eSpark-Backup/eamonelkhedrawi-boarddesign/Design Files/Power-PCB/Deliverables/Renderings/3D-IsometricView.png

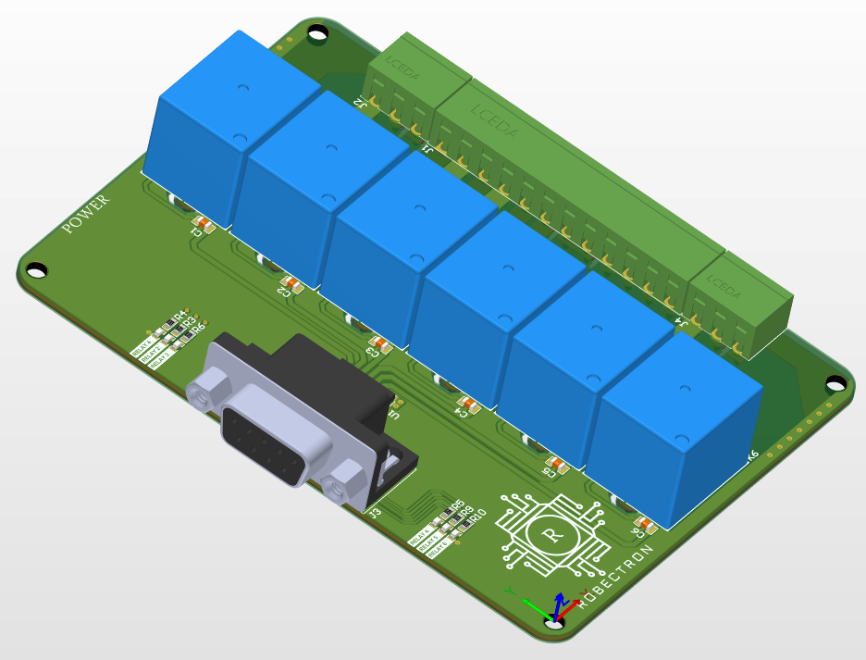
Design Files/Power-PCB/Deliverables/Renderings/3D-IsometricView.png
