eSpark-Backup/eamonelkhedrawi-boarddesign/Design Files/Chemist-PCB/Deliverables/Renderings/2D-BottomView.png

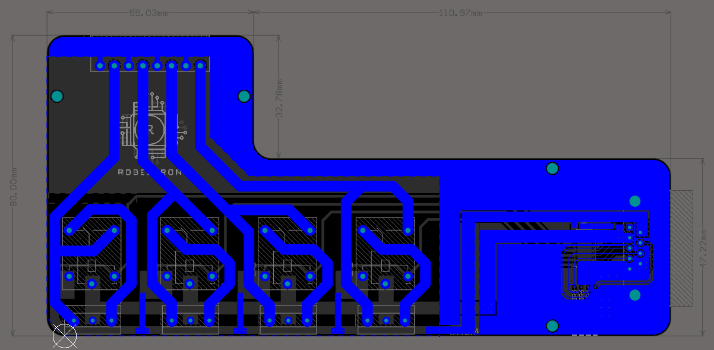
Design Files/Chemist-PCB/Deliverables/Renderings/2D-BottomView.png
