eSpark-Backup/eamonelkhedrawi-boarddesign/Design Files/Chemist-PCB/Deliverables/Renderings/2D-C-View.png

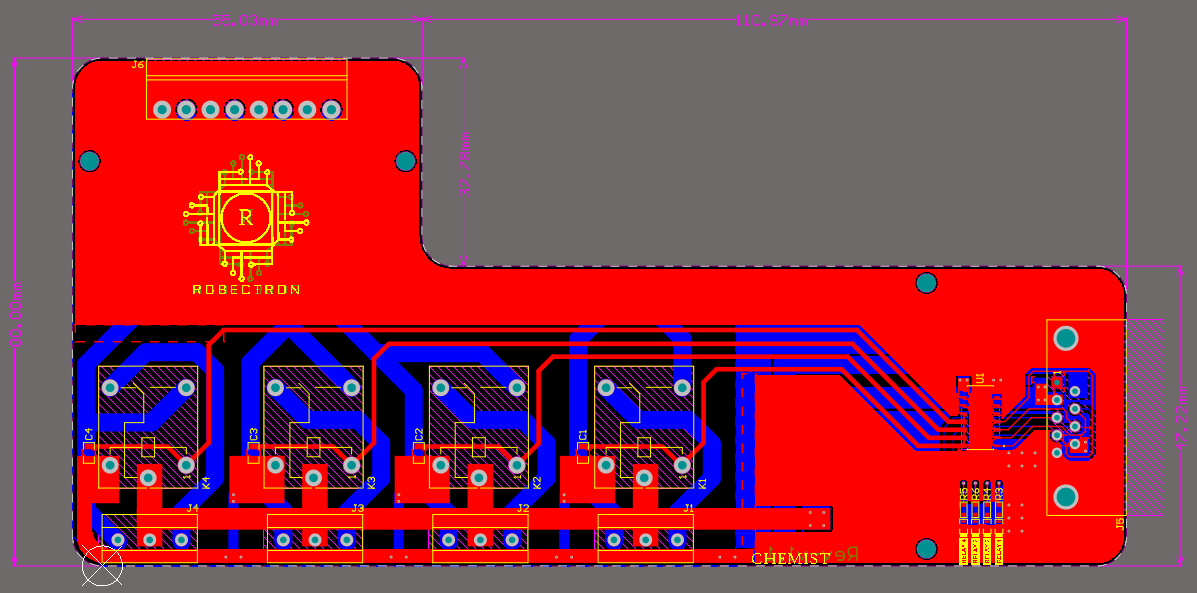
Design Files/Chemist-PCB/Deliverables/Renderings/2D-C-View.png
