eSpark-Backup/eamonelkhedrawi-boarddesign/Design Files/Chemist-PCB/Deliverables/Renderings/2D-TopView.png

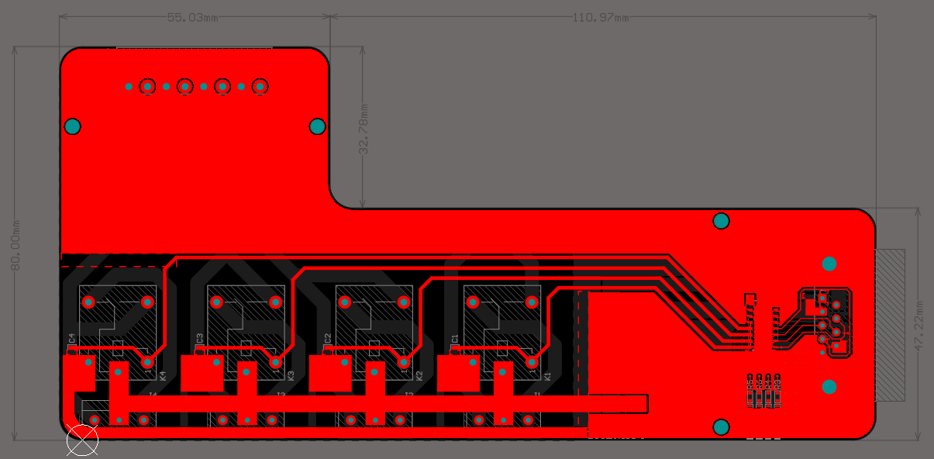
Design Files/Chemist-PCB/Deliverables/Renderings/2D-TopView.png
