eSpark-Backup/eamonelkhedrawi-boarddesign/Design Files/Chemist-PCB/Deliverables/Renderings/3D-BottomView.png

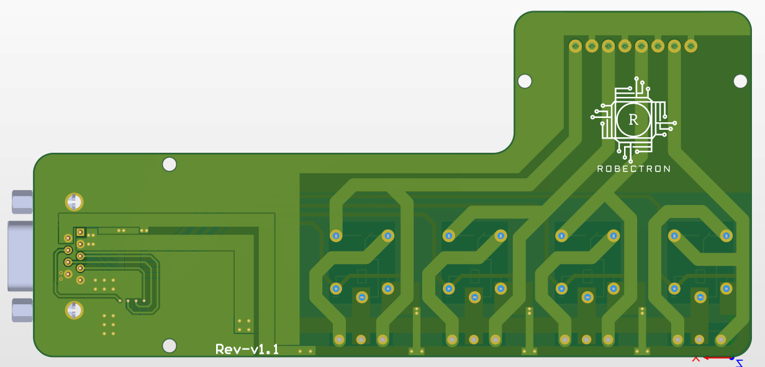
Design Files/Chemist-PCB/Deliverables/Renderings/3D-BottomView.png
