eSpark-Backup/eamonelkhedrawi-boarddesign/Design Files/Chemist-PCB/Deliverables/Renderings/3D-IsometricView.png

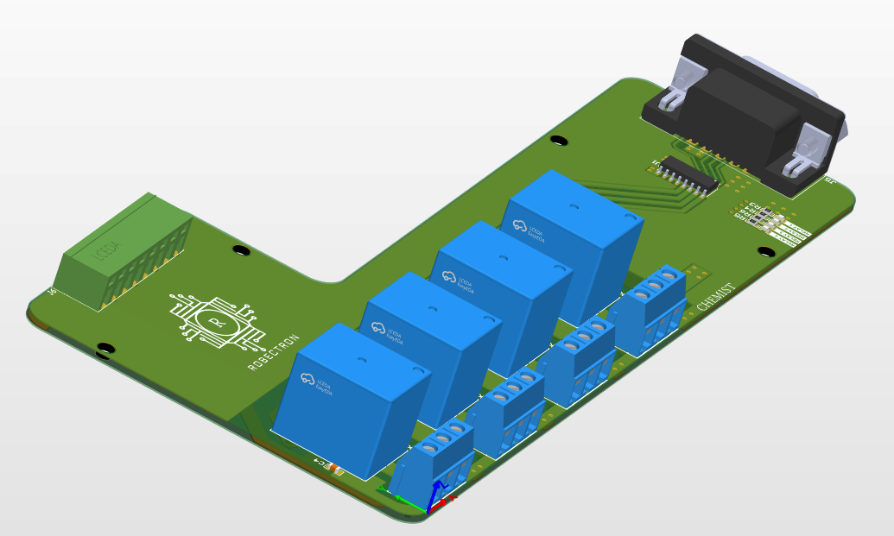
Design Files/Chemist-PCB/Deliverables/Renderings/3D-IsometricView.png
