eSpark-Backup/eamonelkhedrawi-boarddesign/Design Files/Chemist-PCB/Deliverables/Renderings/3D-TopView.png

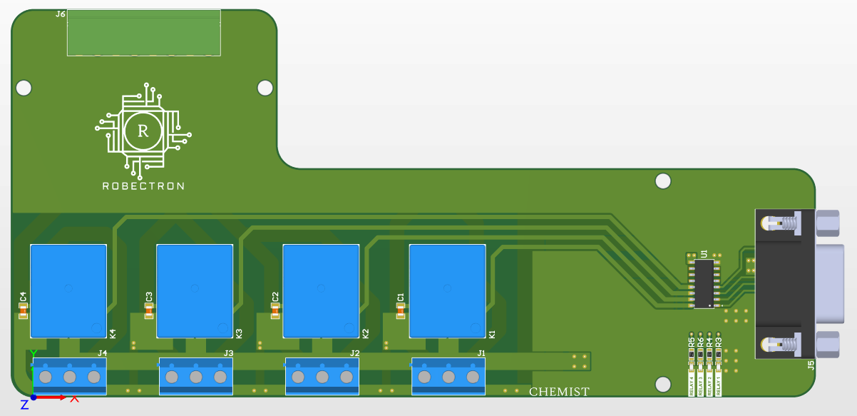
Design Files/Chemist-PCB/Deliverables/Renderings/3D-TopView.png
