eSpark-Backup/eamonelkhedrawi-boarddesign/Design Files/Main-PCB/Deliverables/Renderings/2D-2ndLayerView.png

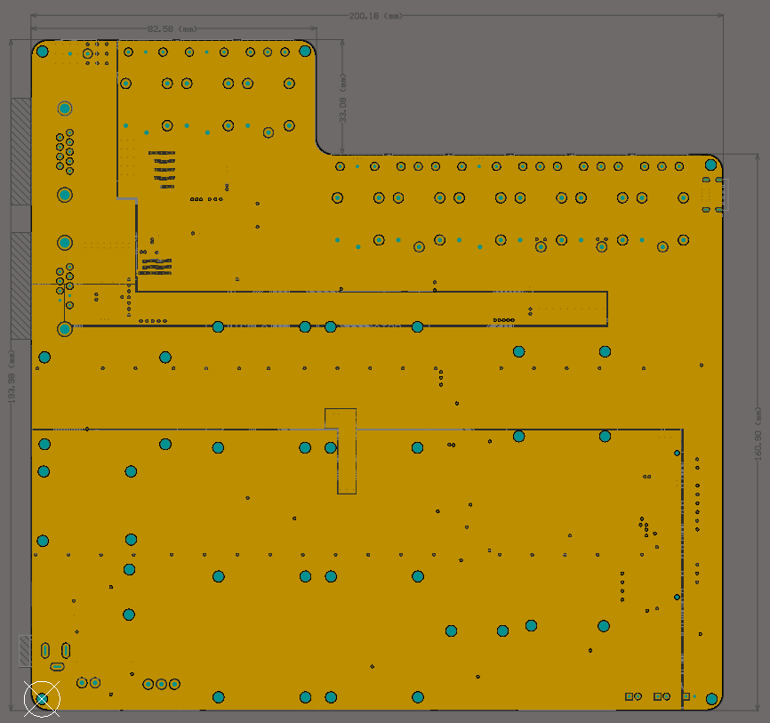
Design Files/Main-PCB/Deliverables/Renderings/2D-2ndLayerView.png
