eSpark-Backup/eamonelkhedrawi-boarddesign/Design Files/Main-PCB/Deliverables/Renderings/2D-3rdLayerView.png

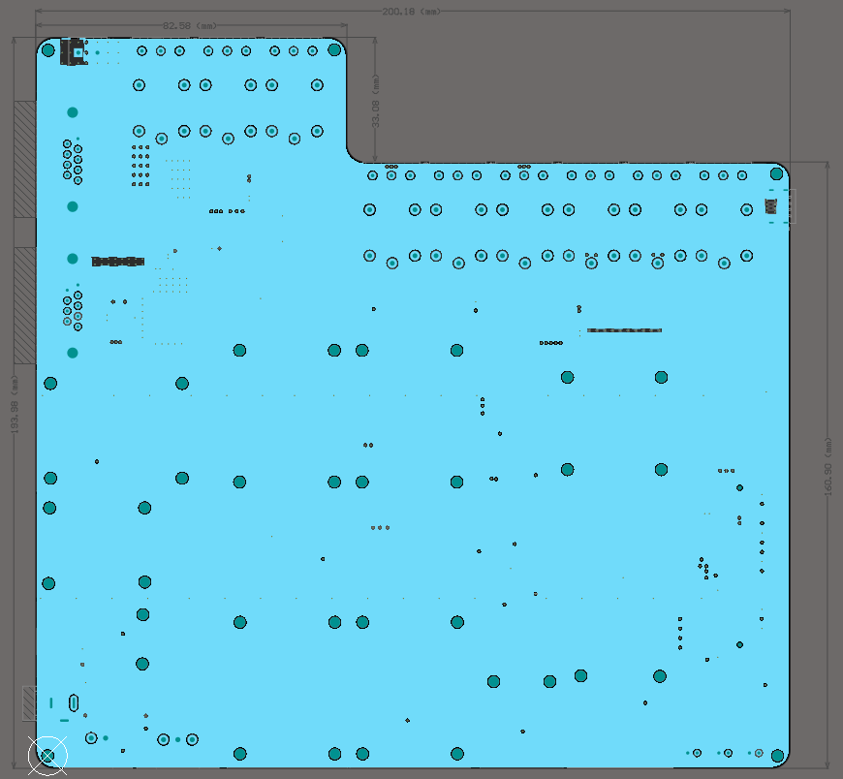
Design Files/Main-PCB/Deliverables/Renderings/2D-3rdLayerView.png
