eSpark-Backup/eamonelkhedrawi-boarddesign/Design Files/Main-PCB/Deliverables/Renderings/2D-BottomView.png

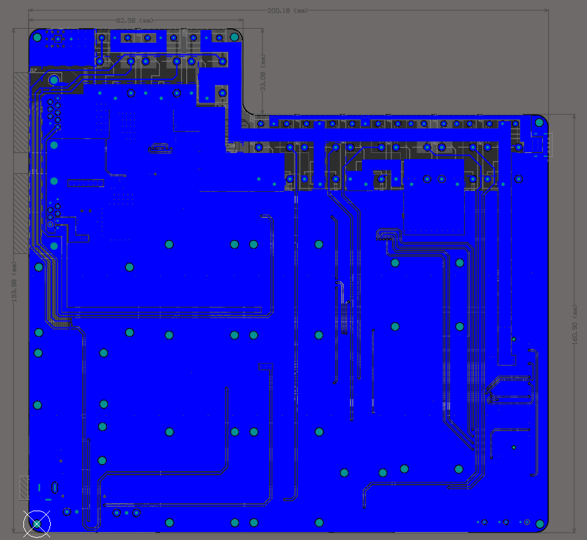
Design Files/Main-PCB/Deliverables/Renderings/2D-BottomView.png
