eSpark-Backup/eamonelkhedrawi-boarddesign/Design Files/Main-PCB/Deliverables/Renderings/2D-C-View.png

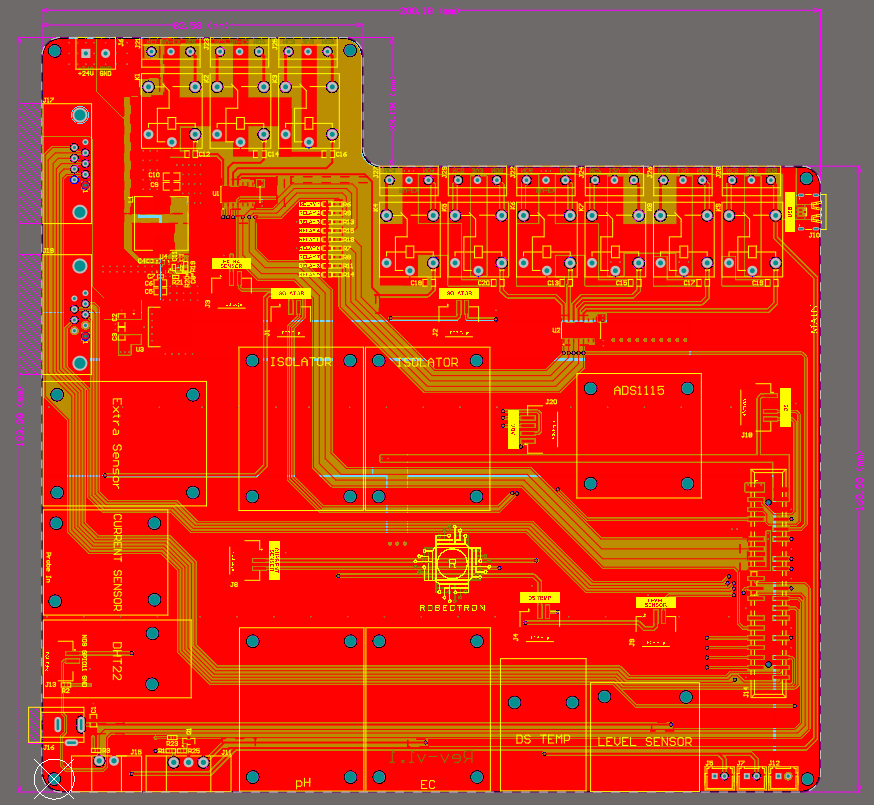
Design Files/Main-PCB/Deliverables/Renderings/2D-C-View.png
