eSpark-Backup/eamonelkhedrawi-boarddesign/Design Files/Main-PCB/Deliverables/Renderings/2D-TopView.png

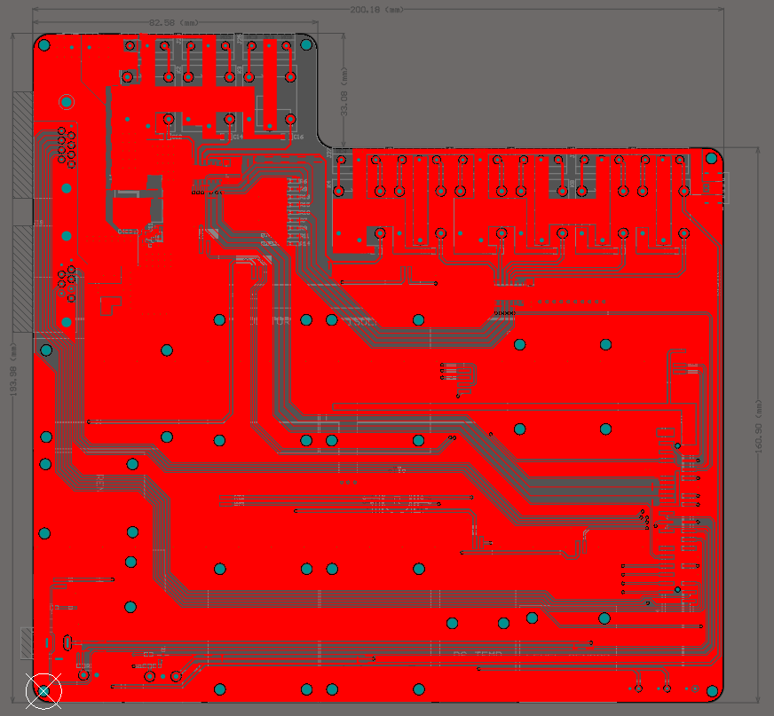
Design Files/Main-PCB/Deliverables/Renderings/2D-TopView.png
