eSpark-Backup/eamonelkhedrawi-boarddesign/Design Files/Main-PCB/Deliverables/Renderings/3D-BottomView.png

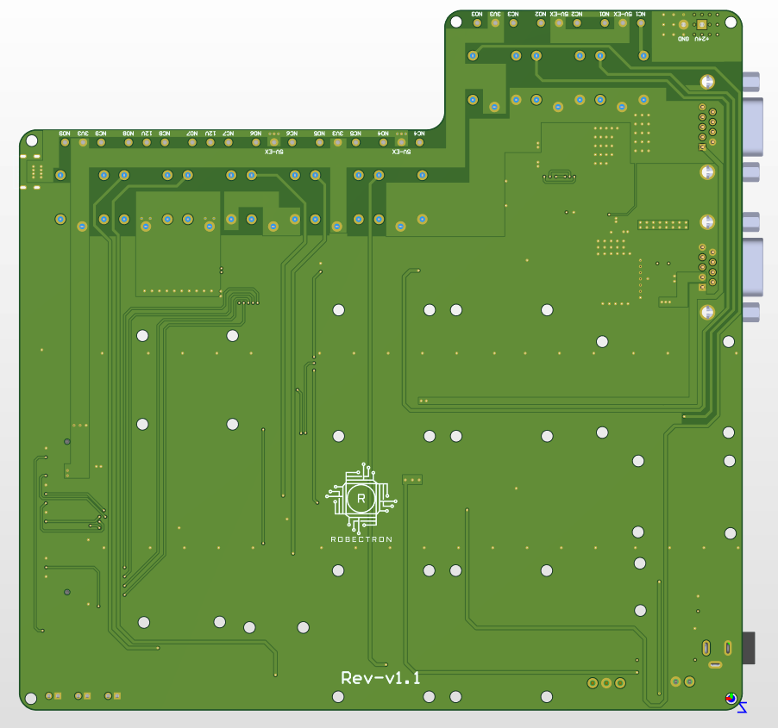
Design Files/Main-PCB/Deliverables/Renderings/3D-BottomView.png
