eSpark-Backup/eamonelkhedrawi-boarddesign/Design Files/Main-PCB/Deliverables/Renderings/3D-IsometricView.png

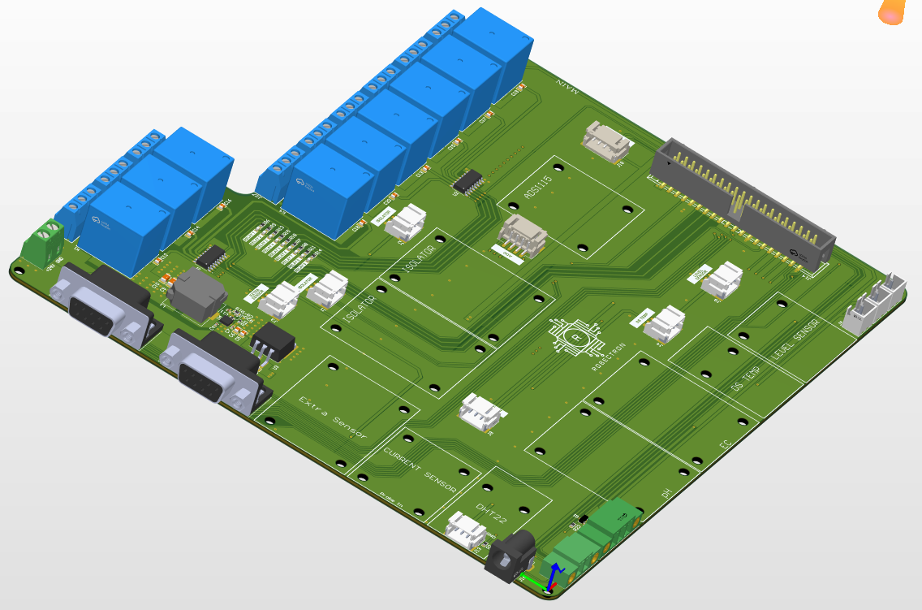
Design Files/Main-PCB/Deliverables/Renderings/3D-IsometricView.png
