eSpark-Backup/eamonelkhedrawi-boarddesign/Design Files/Main-PCB/Deliverables/Renderings/3D-TopView.png

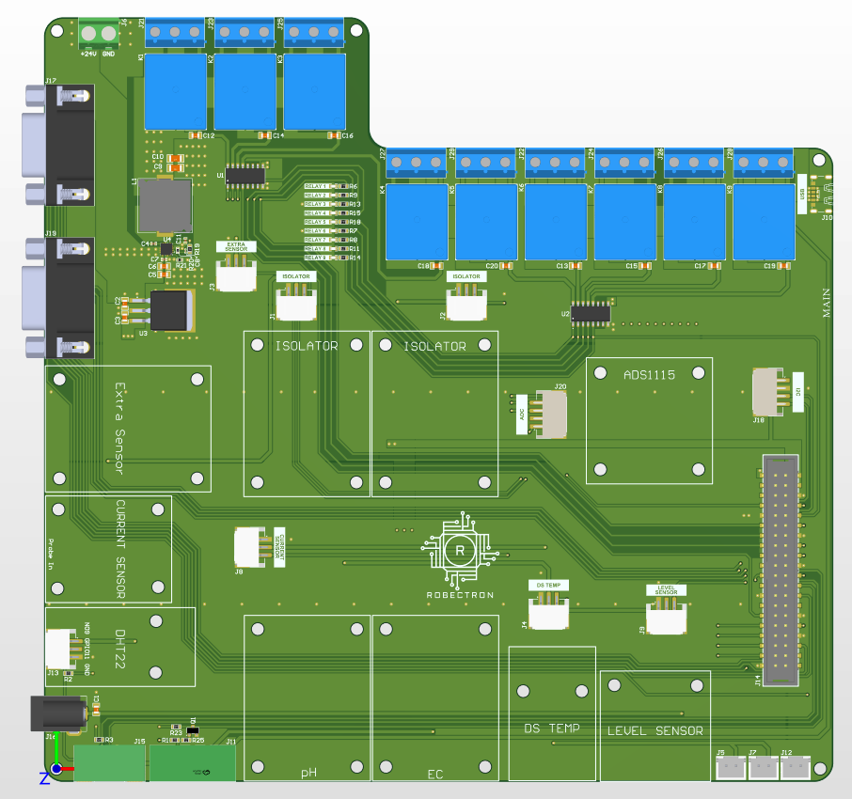
Design Files/Main-PCB/Deliverables/Renderings/3D-TopView.png
