eSpark-Backup/eamonelkhedrawi-boarddesign/Design Files/Power-PCB/Deliverables/Renderings/2D-BottomView.png

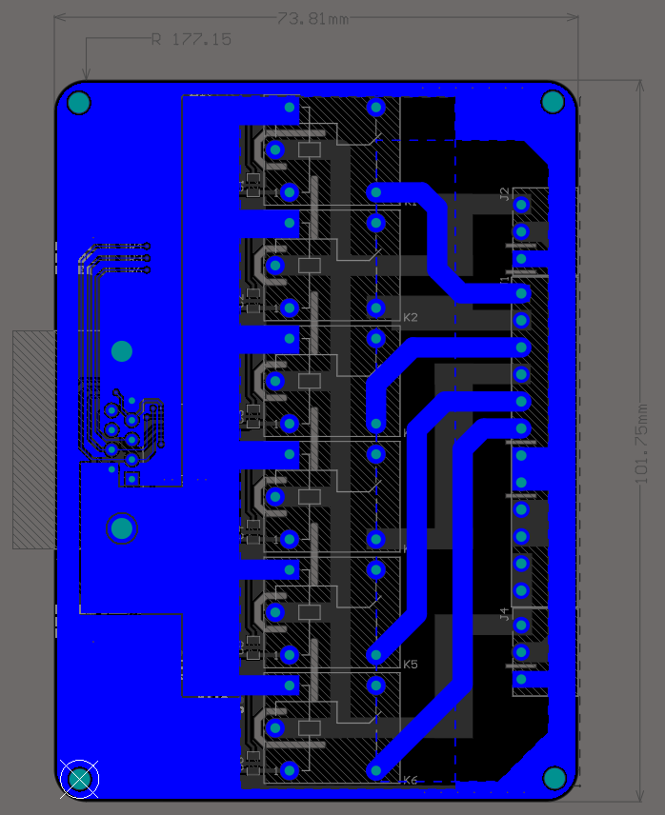
Design Files/Power-PCB/Deliverables/Renderings/2D-BottomView.png
