eSpark-Backup/eamonelkhedrawi-boarddesign/Design Files/Power-PCB/Deliverables/Renderings/2D-C-View.png

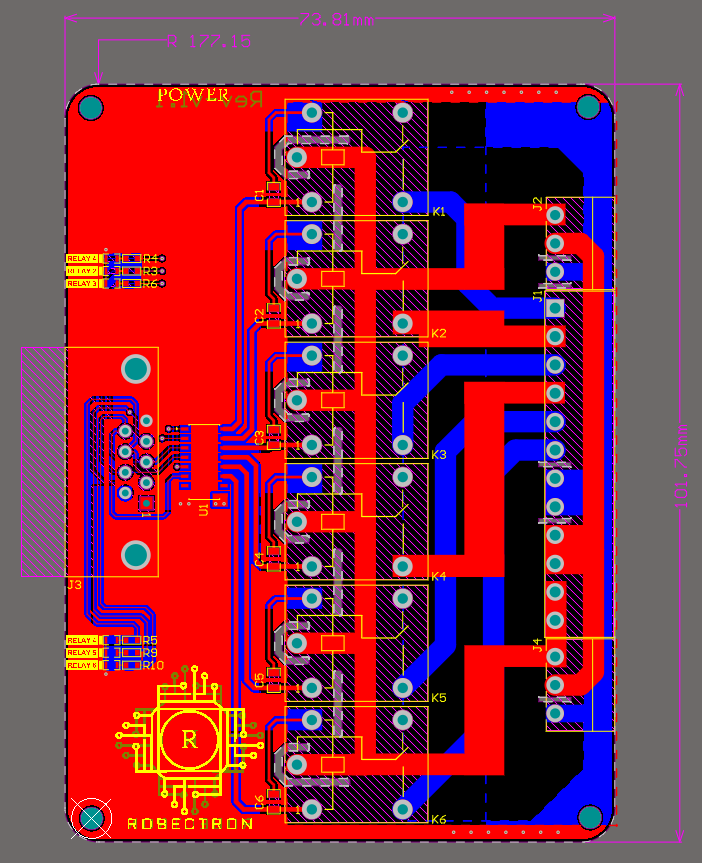
Design Files/Power-PCB/Deliverables/Renderings/2D-C-View.png
