eSpark-Backup/eamonelkhedrawi-boarddesign/Design Files/Power-PCB/Deliverables/Renderings/2D-TopView.png

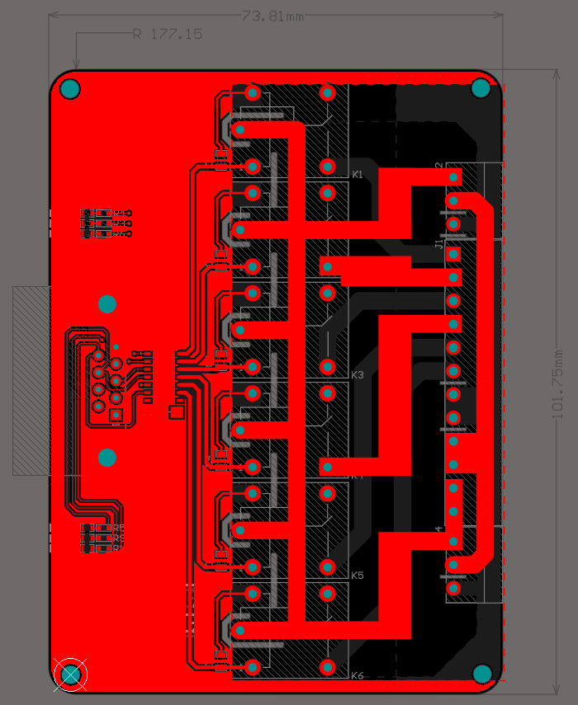
Design Files/Power-PCB/Deliverables/Renderings/2D-TopView.png
