eSpark-Backup/eamonelkhedrawi-boarddesign/Design Files/Power-PCB/Deliverables/Renderings/3D-BottomView.png

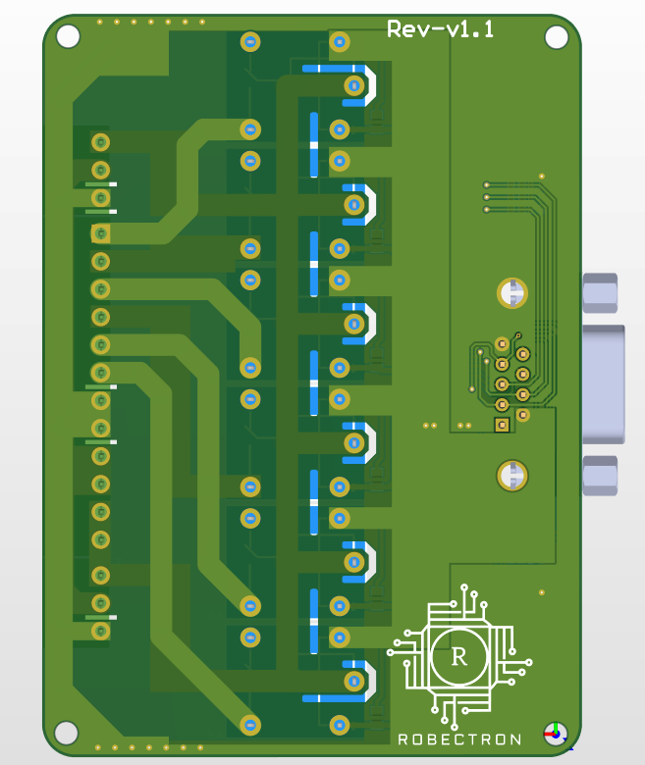
Design Files/Power-PCB/Deliverables/Renderings/3D-BottomView.png
