eSpark-Backup/eamonelkhedrawi-boarddesign/Design Files/Power-PCB/Deliverables/Renderings/3D-TopView.png

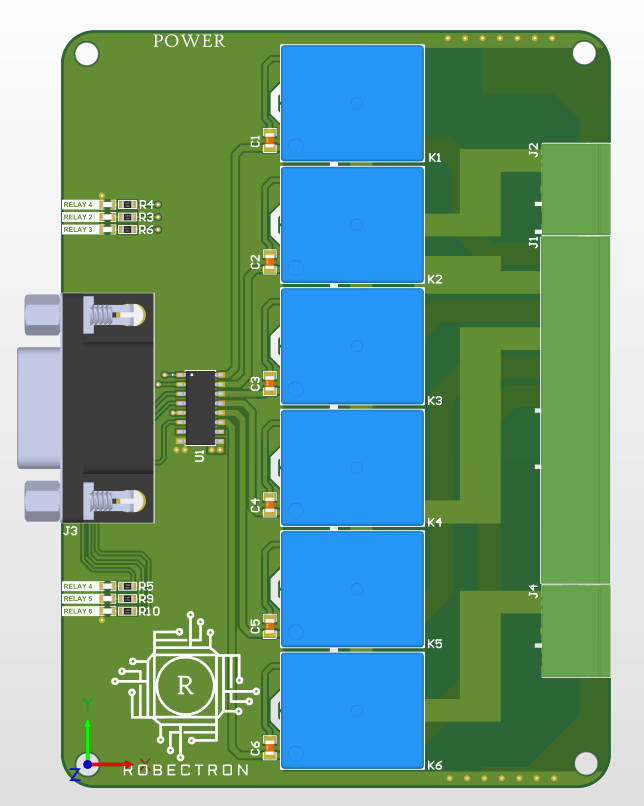
Design Files/Power-PCB/Deliverables/Renderings/3D-TopView.png
