eSpark-Backup/eamonelkhedrawi-boarddesign/Design Files/Power-PCB/BOM/Power-PCB.xlsx

# | Item Type | Designator | Description | Footprint | Manufacturer Part Number | Manufacturer | Value | Quantity | Remarks
1 | Capacitor | C1, C2, C3, C4, C5, C6 | CAP CER 10UF 50V X5R 0805 | Cap-0805 | GRM21BR61H106ME43L | Murata | 10uF | 6
2 | Terminal Block | J1 | 250V 10A 12 Bend -40℃~+105℃ 1 3.81mm 1x12P Green Board Edge/Receptacle-Close Push-Pull,P=3.81mm Pluggable System Terminal Block ROHS | Custom | DB2ERC-3.81-12P-GN | DORABO | - | 1
3 | Terminal Block | J2, J4 | 250V 10A 3 Bend -40℃~+105℃ 1 3.81mm 1x3P Green Board Edge/Receptacle-Close Push-Pull,P=3.81mm Pluggable System Terminal Block ROHS | Custom | DB2ERC-3.81-3P-GN | DORABO | - | 2
4 | D-Sub Connectors | J3 | CONN D-SUB RCPT 9POS R/A SLDR | Custom | LX09-VGA09B-048 | Lian Xin Technology | - | 1
5 | Relays | K1, K2, K3, K4, K5, K6 | 250V@AC 5V 15A SPDT (1 Form C) Plugin,15.6x19.2mm Power Relays ROHS | Custom | SRD-05VDC-SL-C | Ningbo Songle Relay | - | 6
6 | LEDs | LED1, LED2, LED3, LED4, LED5, LED6 | LED RED CLEAR CHIP SMD | LED-0603 | LTST-C193KRKT-5A | Vishay Lite-On | - | 6
7 | Resistor | R3, R4, R5, R6, R9, R10 | RES SMD 220 OHM 1% 1/10W 0603 | Res-0603 | CRCW0603220RFKEA | Vishay | 220R | 6
8 | IC | U1 | IC PWR RELAY 7NPN 1:1 16SOIC | 16-SOIC (0.154", 3.90mm Width) | ULN2003AIDR | Texas Instruments | - | 1
