eSpark-Backup/eamonelkhedrawi-boarddesign/Design Files/Chemist-PCB/BOM/Chemist-PCB.xlsx

# | Item Type | Designator | Description | Footprint | Manufacturer Part Number | Manufacturer | Value | Quantity | Remarks
1 | Capacitor | C1, C2, C3, C4 | CAP CER 10UF 50V X5R 0805 | Cap-0805 | GRM21BR61H106ME43L | Murata | 10uF | 4
2 | Screw terminal | J1, J2, J3, J4 | 1x3P 15A 300V Blue 14~22 Straight 5mm 1.5 1 3 Plugin,P=5mm Screw terminal ROHS | Custom | XY301V-A-5.0-3P | Ningbo Xinlaiya Elec | - | 4
3 | D-Sub Connectors | J5 | CONN D-SUB RCPT 9POS R/A SLDR | Custom | LX09-VGA09B-048 | Lian Xin Technology | - | 1
4 | Terminal Block | J6 | 250V 10A 8 Bend -40℃~+105℃ 1 3.81mm 1x8P Green Board Edge/Receptacle-Close Push-Pull,P=3.81mm Pluggable System Terminal Block ROHS | Custom | DB2ERC-3.81-8P-GN | DORABO | - | 1
5 | Relays | K1, K2, K3, K4 | 250V@AC 5V 15A SPDT (1 Form C) Plugin,15.6x19.2mm Power Relays ROHS | Custom | SRD-05VDC-SL-C | Ningbo Songle Relay | - | 4
6 | LEDs | LED1, LED2, LED3, LED4 | LED RED CLEAR CHIP SMD | LED-0603 | LTST-C193KRKT-5A | Vishay Lite-On | - | 4
7 | Resistor | R3, R4, R5, R6 | RES SMD 220 OHM 1% 1/10W 0603 | Res-0603 | CRCW0603220RFKEA | Vishay | 220R | 4
8 | IC | U1 | IC PWR RELAY 7NPN 1:1 16SOIC | 16-SOIC (0.154", 3.90mm Width) | ULN2003AIDR | Texas Instruments | - | 1
