eSpark-Backup/eamonelkhedrawi-boarddesign/Design Files/Main-PCB/BOM/EamonElkhedrawi-BoardDesign.xlsx

# | Item Type | Designator | Description | Footprint | Manufacturer Part Number | Manufacturer | Value | Quantity | Remarks
1 | Capacitor | C1, C3 | CAP CER 22UF 35V X5R 0805 | Cap-0805 | C2012X5R1V226MT000E | TDK Corporation | 22uF | 2
2 | Capacitor | C2, C5, C6, C12, C13, C14, C15, C16, C17, C18, C19, C20 | CAP CER 10UF 50V X5R 0805 | Cap-0805 | GRM21BR61H106ME43L | Murata | 10uF | 12
3 | Capacitor | C4 | CAP CER 0.1UF 50V X7R 0402 | cap-0402 | C1005X7R1H104KT000F | TDK | 100nF | 1
4 | Capacitor | C7 | CAP CER 0.1UF 50V X5R 0402 | Cap-0402 | C1005X5R1H104K050BB | TDK | 0.1uF | 1
5 | Capacitor | C8 | CAP CER 150PF 25V X7R 0402 | Cap-0402 | CC0402KRX7R8BB151 | Yageo | 150pF | 1
6 | Capacitor | C9, C10 | CAP CER 47UF 25V X5R 1206 | Cap-1206 | C3216X5R1E476M160AC | TDK | 47uF | 2
7 | Capacitor | C11 | CAP CER 0.022UF 16V X5R 0402 | Cap-0402 | CC0402KRX5R7BB223 | Yageo | 22nF | 1
8 | Connector | J1, J2, J3, J4, J8, J9, J13 | 1x3P 3P 1 2mm 3 -25℃~+85℃ 2A Surface Mount，Right Angle SMD,P=2mm,Surface Mount，Right Angle Wire To Board Connector ROHS | Custom | WAFER-PH2.0-3PWB |  | - | 7
9 | Wire To Board Connector | J5, J7, J12 | 1x2P 2P XH 1 2.5mm 2 Straight Plugin,P=2.5mm Wire To Board Connector ROHS | Custom | HX25003-2A | HX | - | 3
10 | Terminal Blocks | J6 | TERM BLK 2P SIDE ENT 5.08MM PCB | Custom | 1729128 | Phoenix Contact | - | 1
11 | Type-C SMD | J10 | 1 Surface Mount，Right Angle 6P Female -40℃~+85℃ Type-C SMD USB Connectors ROHS | TYPE-C 6P | TYPE-C 6P | SHOU HAN | - | 1
12 | Terminal Block | J11 | 300V 8A 3 Bend -40℃~+105℃ 1 3.81mm 1x3P Green Board Edge/Receptacle-Close Screw fixed Push-Pull,P=3.81mm Pluggable System Terminal Block ROHS | Custom | KF2EDGRM-3.81-3P | Cixi Kefa Elec | - | 1
13 | IDC Connector | J14 | 2.54mm -40℃~+105℃ Brick nogging 3A 2x20P 20 Push - Pull 2.54mm 2 SMD,P=2.54mm IDC Connectors ROHS | Custom | BH-00181 | Liansheng | - | 1
14 | Terminal Block | J15 | 300V 8A 2 Bend -40℃~+105℃ 1 3.81mm 1x2P Green Board Edge/Receptacle-Close Screw fixed Push-Pull,P=3.81mm Pluggable System Terminal Block ROHS | Custom | KF2EDGRM-3.81-2P | Cixi Kefa Elec | - | 1
15 | DC Power Connector | J16 | 2mm 6.4mm 500mA 30V Plugin DC Power Connector ROHS | Custom | DC-005-20A | Korean Hroparts Elec | - | 1
16 | D-Sub Connectors | J17, J19 | CONN D-SUB RCPT 9POS R/A SLDR | Custom | LX09-VGA09B-048 | Lian Xin Technology | - | 2
17 | Connector | J18, J20 | 1x4P 1 2mm Male pin 4 -25℃~+85℃ 2A Surface Mount SMD,P=2mm Wire To Board / Wire To Wire Connector ROHS C3029442 | Custom | WAFER-PH2.0-4PWB |  | - | 2
18 | Screw terminal | J21, J22, J23, J24, J25, J26, J27, J28, J29 | 1x3P 15A 300V Blue 14~22 Straight 5mm 1.5 1 3 Plugin,P=5mm Screw terminal ROHS | Custom | XY301V-A-5.0-3P | Ningbo Xinlaiya Elec | - | 9
19 | Relays | K1, K2, K3, K4, K5, K6, K7, K8, K9 | 250V@AC 5V 15A SPDT (1 Form C) Plugin,15.6x19.2mm Power Relays ROHS | Custom | SRD-05VDC-SL-C | Ningbo Songle Relay | - | 9
20 | Inductor | L1 | 15A 4.7uH ±20% 24A SMD,13.5x12.6mm Power Inductors ROHS | Custom | MWSA1206S-4R7MT | Sunlord | 4.7uH | 1
21 | LEDs | LED1, LED2, LED3, LED4, LED5, LED6, LED7, LED8, LED9 | LED RED CLEAR CHIP SMD | LED-0603 | LTST-C193KRKT-5A | Vishay Lite-On | - | 9
22 | Mosfet | Q1 | TRANS NPN 40V 0.6A SMD SOT23-3 | SOT-23 | MMBT2222A-7-F | Diodes | - | 1
23 | Resistor | R1, R3, R23 | RES 10K OHM 1% 1/10W 0603, 100mW Thick Film Resistors 75V ±100ppm/℃ ±1% 10kΩ 0603 Chip Resistor - Surface Mount ROHS | Res-0603 | 0603WAF1002T5E | UNI-ROYAL(Uniroyal Elec) | 10K | 3
24 | Resistor | R2 | RES SMD 4.7K OHM 1% 1/10W 0603 | Res-0603 | RC0603FR-074K7L | Yageo | 4.7K | 1
25 | Resistor | R6, R7, R8, R9, R11, R13, R14, R15, R18 | RES SMD 220 OHM 1% 1/10W 0603 | Res-0603 | CRCW0603220RFKEA | Vishay | 220R | 9
26 | Resistor | R19 | RES 30K OHM 1% 1/10W 0603 | Res-0603 | RC0603FR-0730KL | Yageo | 30K | 1
27 | Resistor | R20 | RES SMD 4.12K OHM 1% 1/16W 0402 | Res-0402 | CRCW04024K12FKED | Vishay | 4.12K | 1
28 | Resistor | R21 | RES SMD 30.1KOHM 0.1% 1/16W 0402 | Res-0402 | RT0402BRD0730K1L | Yageo | 30.1K | 1
29 | Resistor | R25 | RES SMD 1.1K OHM 0.1% 1/10W 0603 | Res-0603 | RT0603BRD071K1L | Yageo | 1.1k | 1
30 | IC | U1, U2 | IC PWR RELAY 7NPN 1:1 16SOIC | 16-SOIC (0.154", 3.90mm Width) | ULN2003AIDR | Texas Instruments | - | 2
31 | IC | U3 | IC REG LIN 12V 1.5A DDPAK/TO263 | TO-263 (DDPAK-3) | LM340SX-12/NOPB | TI National Semiconductor | - | 1
32 | IC | U4 | 4.5V TO 28V INPUT, 8A SYNCHRONOU | 10-VQFN-HR (3x3) | TPS56837HRPAR | Texas Instruments | - | 1
