eSpark-Backup/eamonelkhedrawi-boarddesign/Design Files/Main-PCB/Deliverables/Supporting Files/MainPCB.step

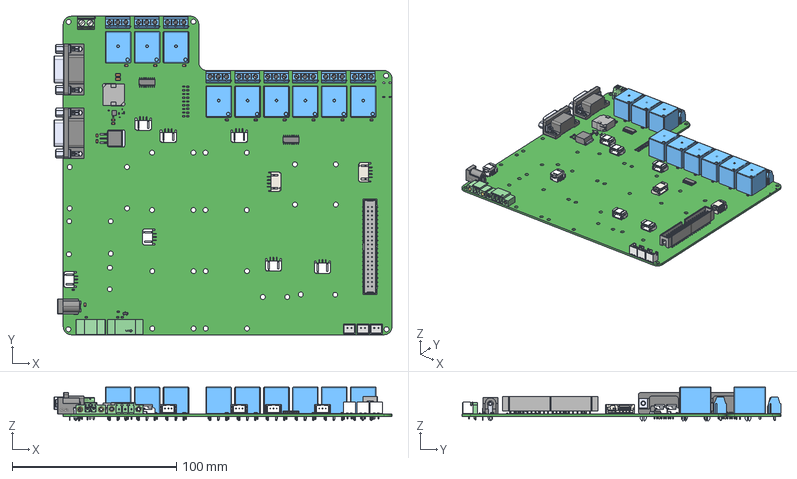
[picture p21: CAD file, 2024-06-03]
Design Files/Main-PCB/Deliverables/Supporting Files/MainPCB.step
205.8 x 194.0 x 20.7 mm
TPS56637RPAR--3DModel-STEP-56544
LM340SX-12_NOPB
MC14511BDG x 2
User Library-RESC1608X05N x 15
User Library-RES_1005-0402 x 2
CircuitWorks-SOT-23
User Library-LED SMD0603 x 9
srp1270-4r7m_RGB8421504
WAFER-PH2.0-4PWB x 2
A-DF 09 A_KG-T2S_A-DF 09 A_KG-T2S x 2
User Library-0805 SMD Capacitor x 14
User Library-Capacitor 0402 x 3
User Library-1206 SMD Capacitor x 2
User Library-SMD Ceramic Capacitors_0201 (0603)_AB
