eSpark-Backup/eamonelkhedrawi-boarddesign/Design Files/Chemist-PCB/Deliverables/Supporting Files/Chemist.step

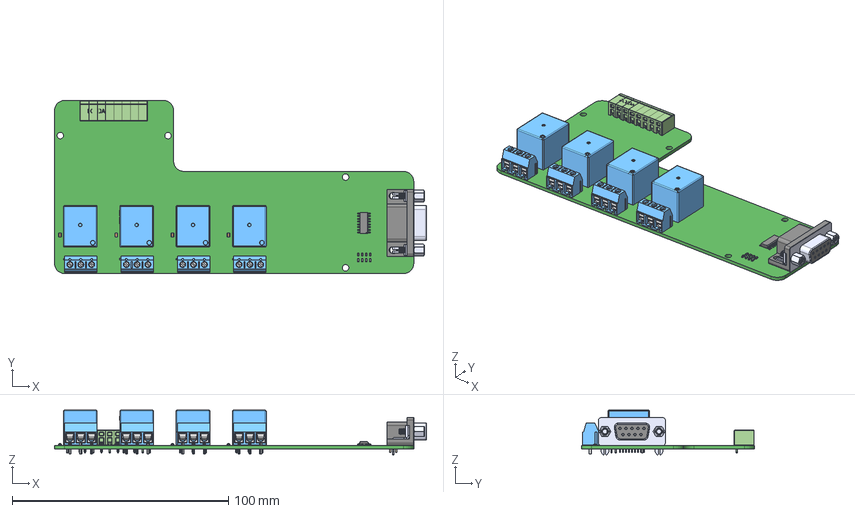
[picture p22: CAD file, 2024-06-03]
Design Files/Chemist-PCB/Deliverables/Supporting Files/Chemist.step
171.9 x 80.0 x 20.7 mm
MC14511BDG
User Library-RESC1608X05N x 4
User Library-LED SMD0603 x 4
A-DF 09 A_KG-T2S_A-DF 09 A_KG-T2S
User Library-0805 SMD Capacitor x 4
