eSpark-Backup/eamonelkhedrawi-boarddesign/Design Files/Power-PCB/Deliverables/Supporting Files/Power.step

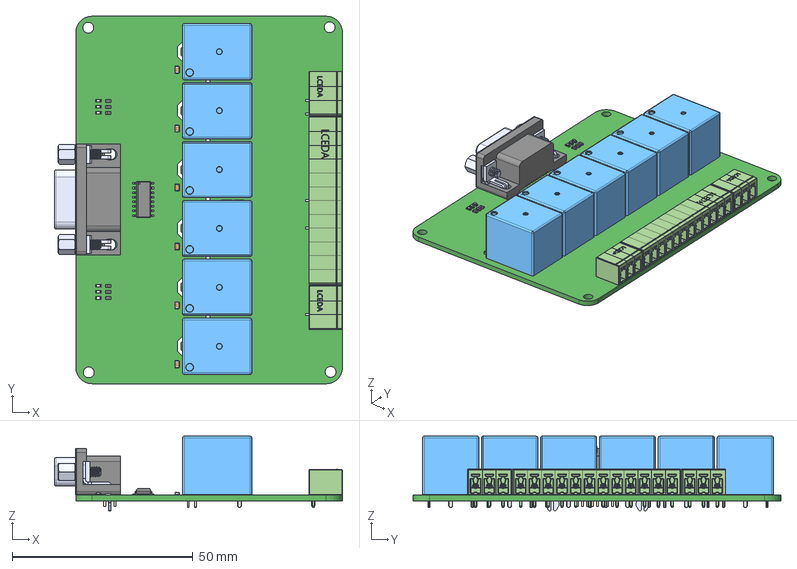
[picture p23: CAD file, 2024-06-03]
Design Files/Power-PCB/Deliverables/Supporting Files/Power.step
79.7 x 101.8 x 20.7 mm
MC14511BDG
User Library-RESC1608X05N x 6
User Library-LED SMD0603 x 6
A-DF 09 A_KG-T2S_A-DF 09 A_KG-T2S
User Library-0805 SMD Capacitor x 6
