eSpark-Backup/eamonelkhedrawi-boarddesign/(list of files, cad)

Other CAD files:
Design Files/Chemist-PCB/Deliverables/Supporting Files/Chemist.DWG
Design Files/Chemist-PCB/Deliverables/Supporting Files/Chemist.DXF
Design Files/Main-PCB/Deliverables/Supporting Files/MainPCB.DWG
Design Files/Main-PCB/Deliverables/Supporting Files/MainPCB.DXF
Design Files/Power-PCB/Deliverables/Supporting Files/Power.DWG
Design Files/Power-PCB/Deliverables/Supporting Files/Power.DXF
