eSpark-Backup/eamonelkhedrawi-boarddesign/Design Files/Main-PCB/Deliverables/Schematic/EamonElkhedrawi-BoardDesign.pdf

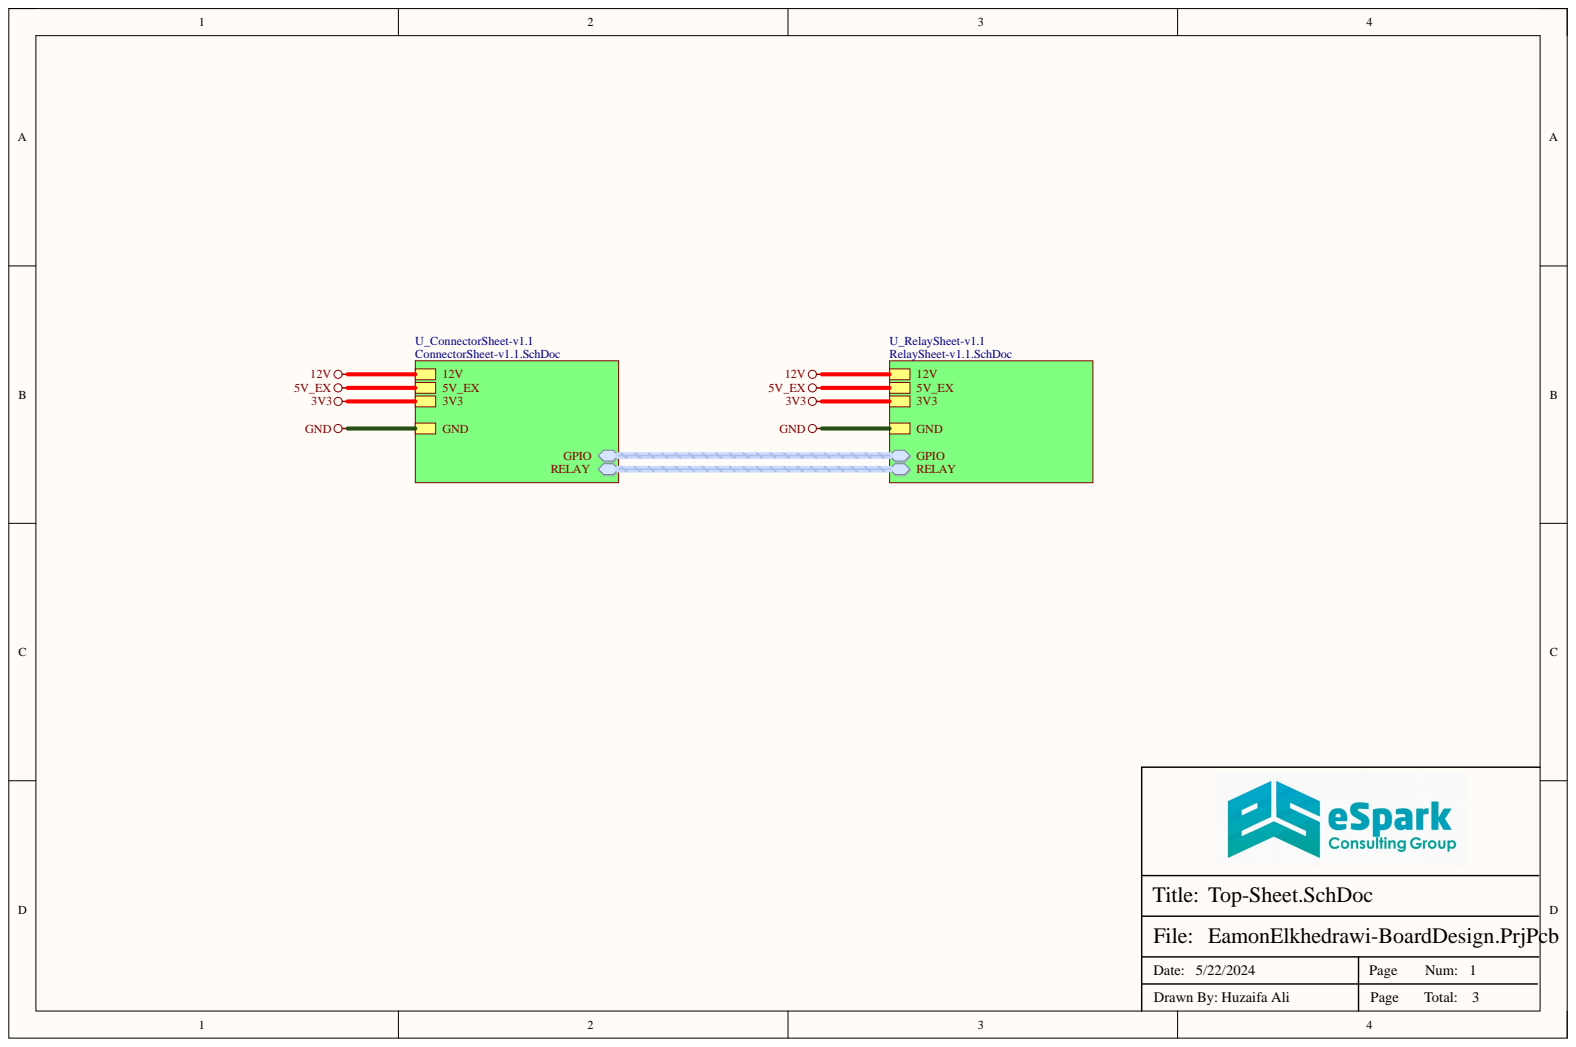
[picture p24: page 1]

Date: 5/22/2024 | Page Num: 1

Drawn By: Huzaifa Ali | Page Total: 3

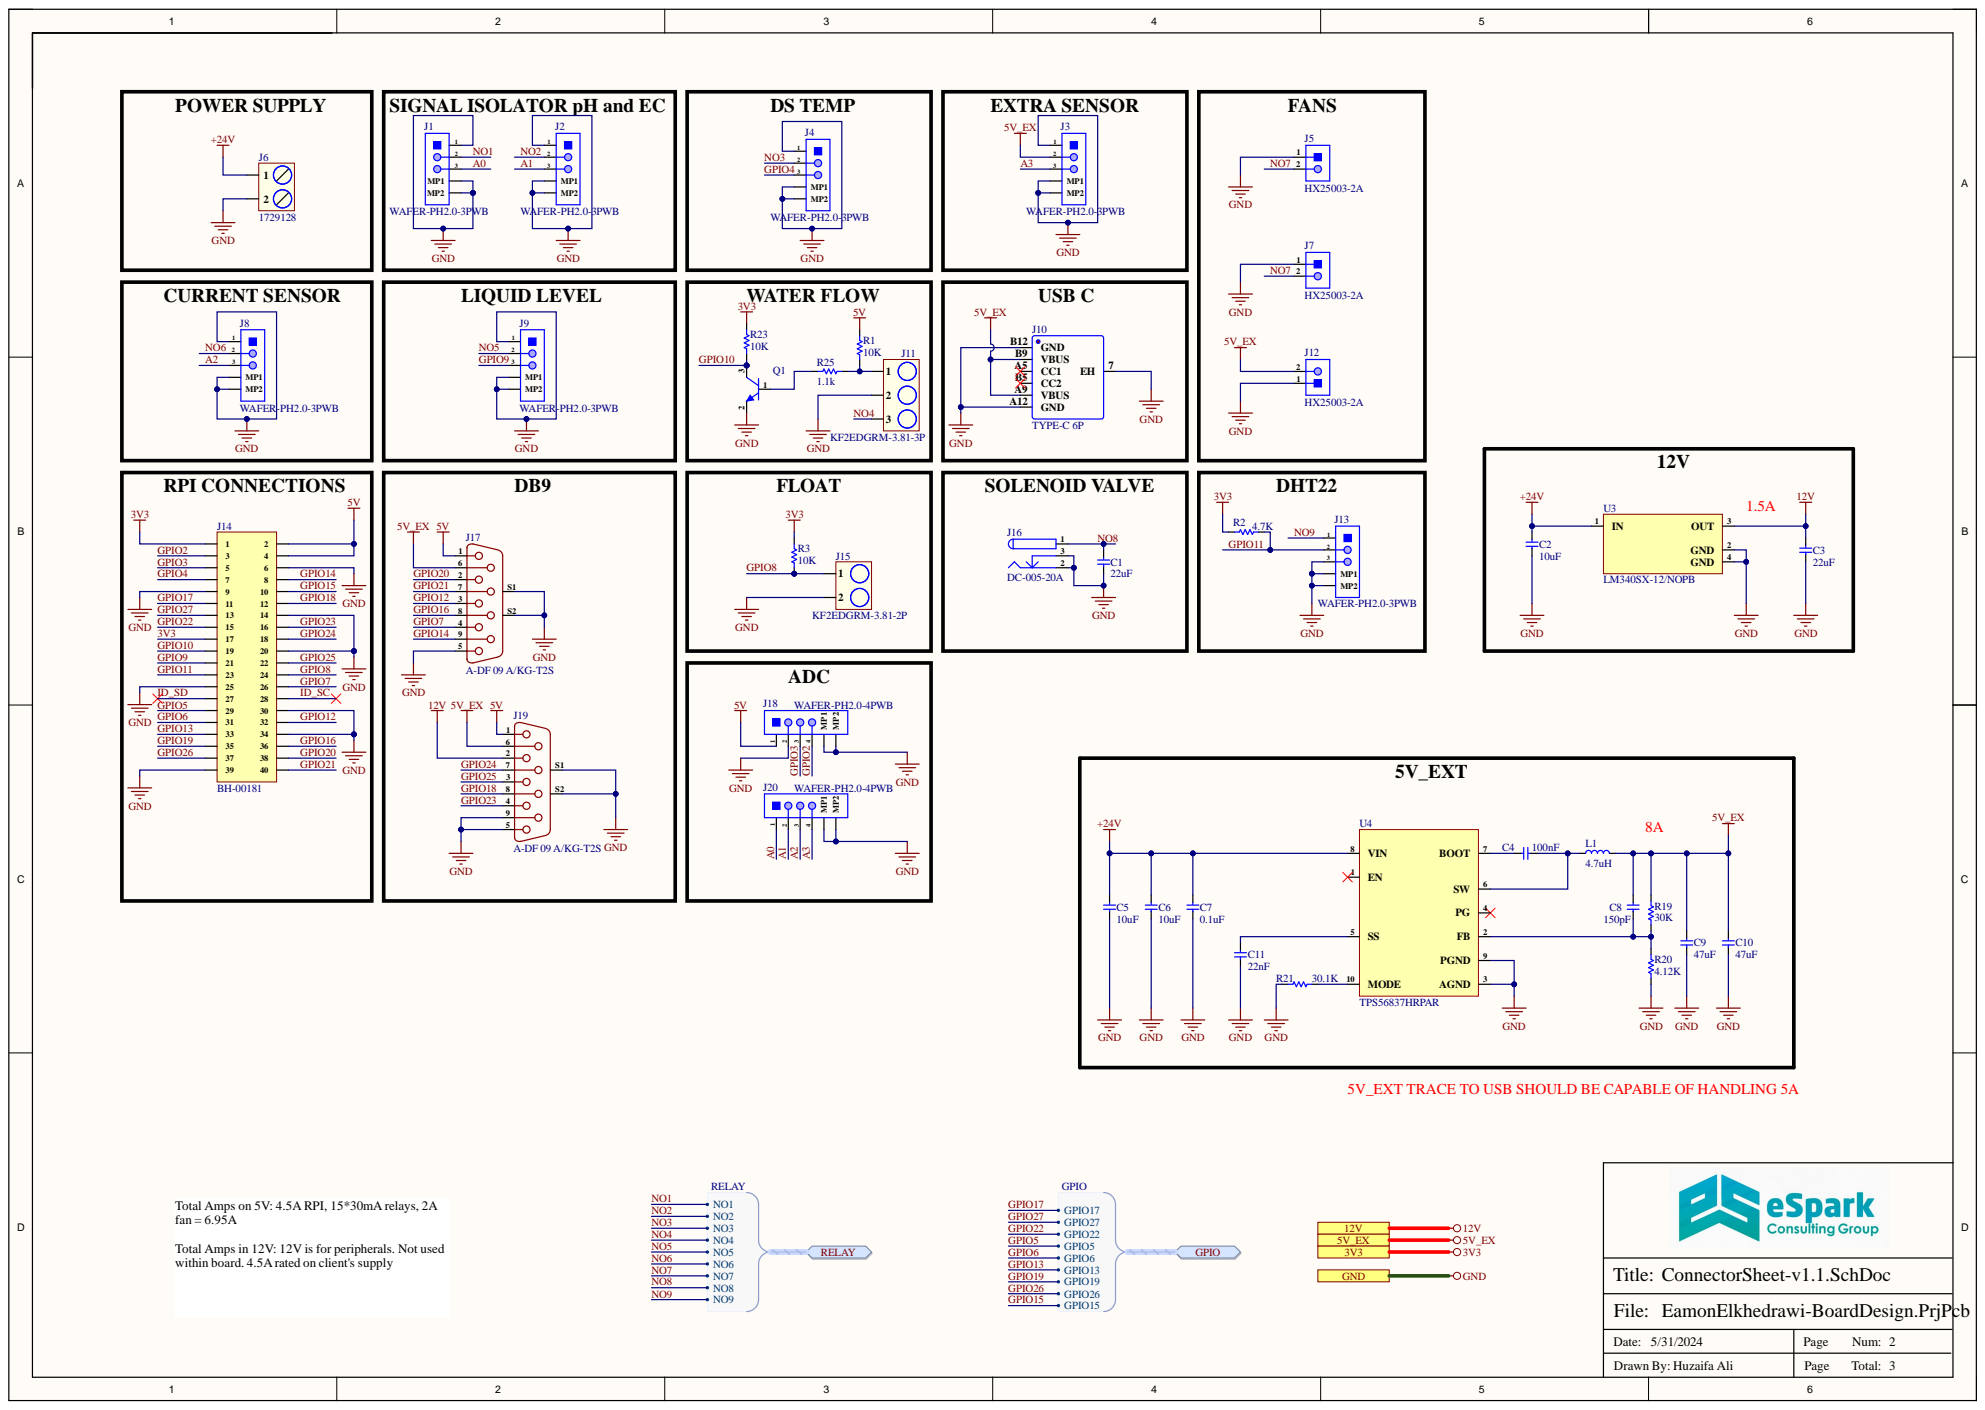
[picture p25: page 2]

GPIO15 GND | GPIO21 7 GPIO12 3

5V_EXT TRACE TO USB SHOULD BE CAPABLE OF HANDLING 5A

Total Amps on 5V: 4.5A RPI, 15*30mA relays, 2A
fan = 6.95A

Total Amps in 12V: 12V is for peripherals. Not used
within board. 4.5Arated on client's supply

Date: 5/31/2024 | Page Num: 2

Drawn By: Huzaifa Ali | Page Total: 3

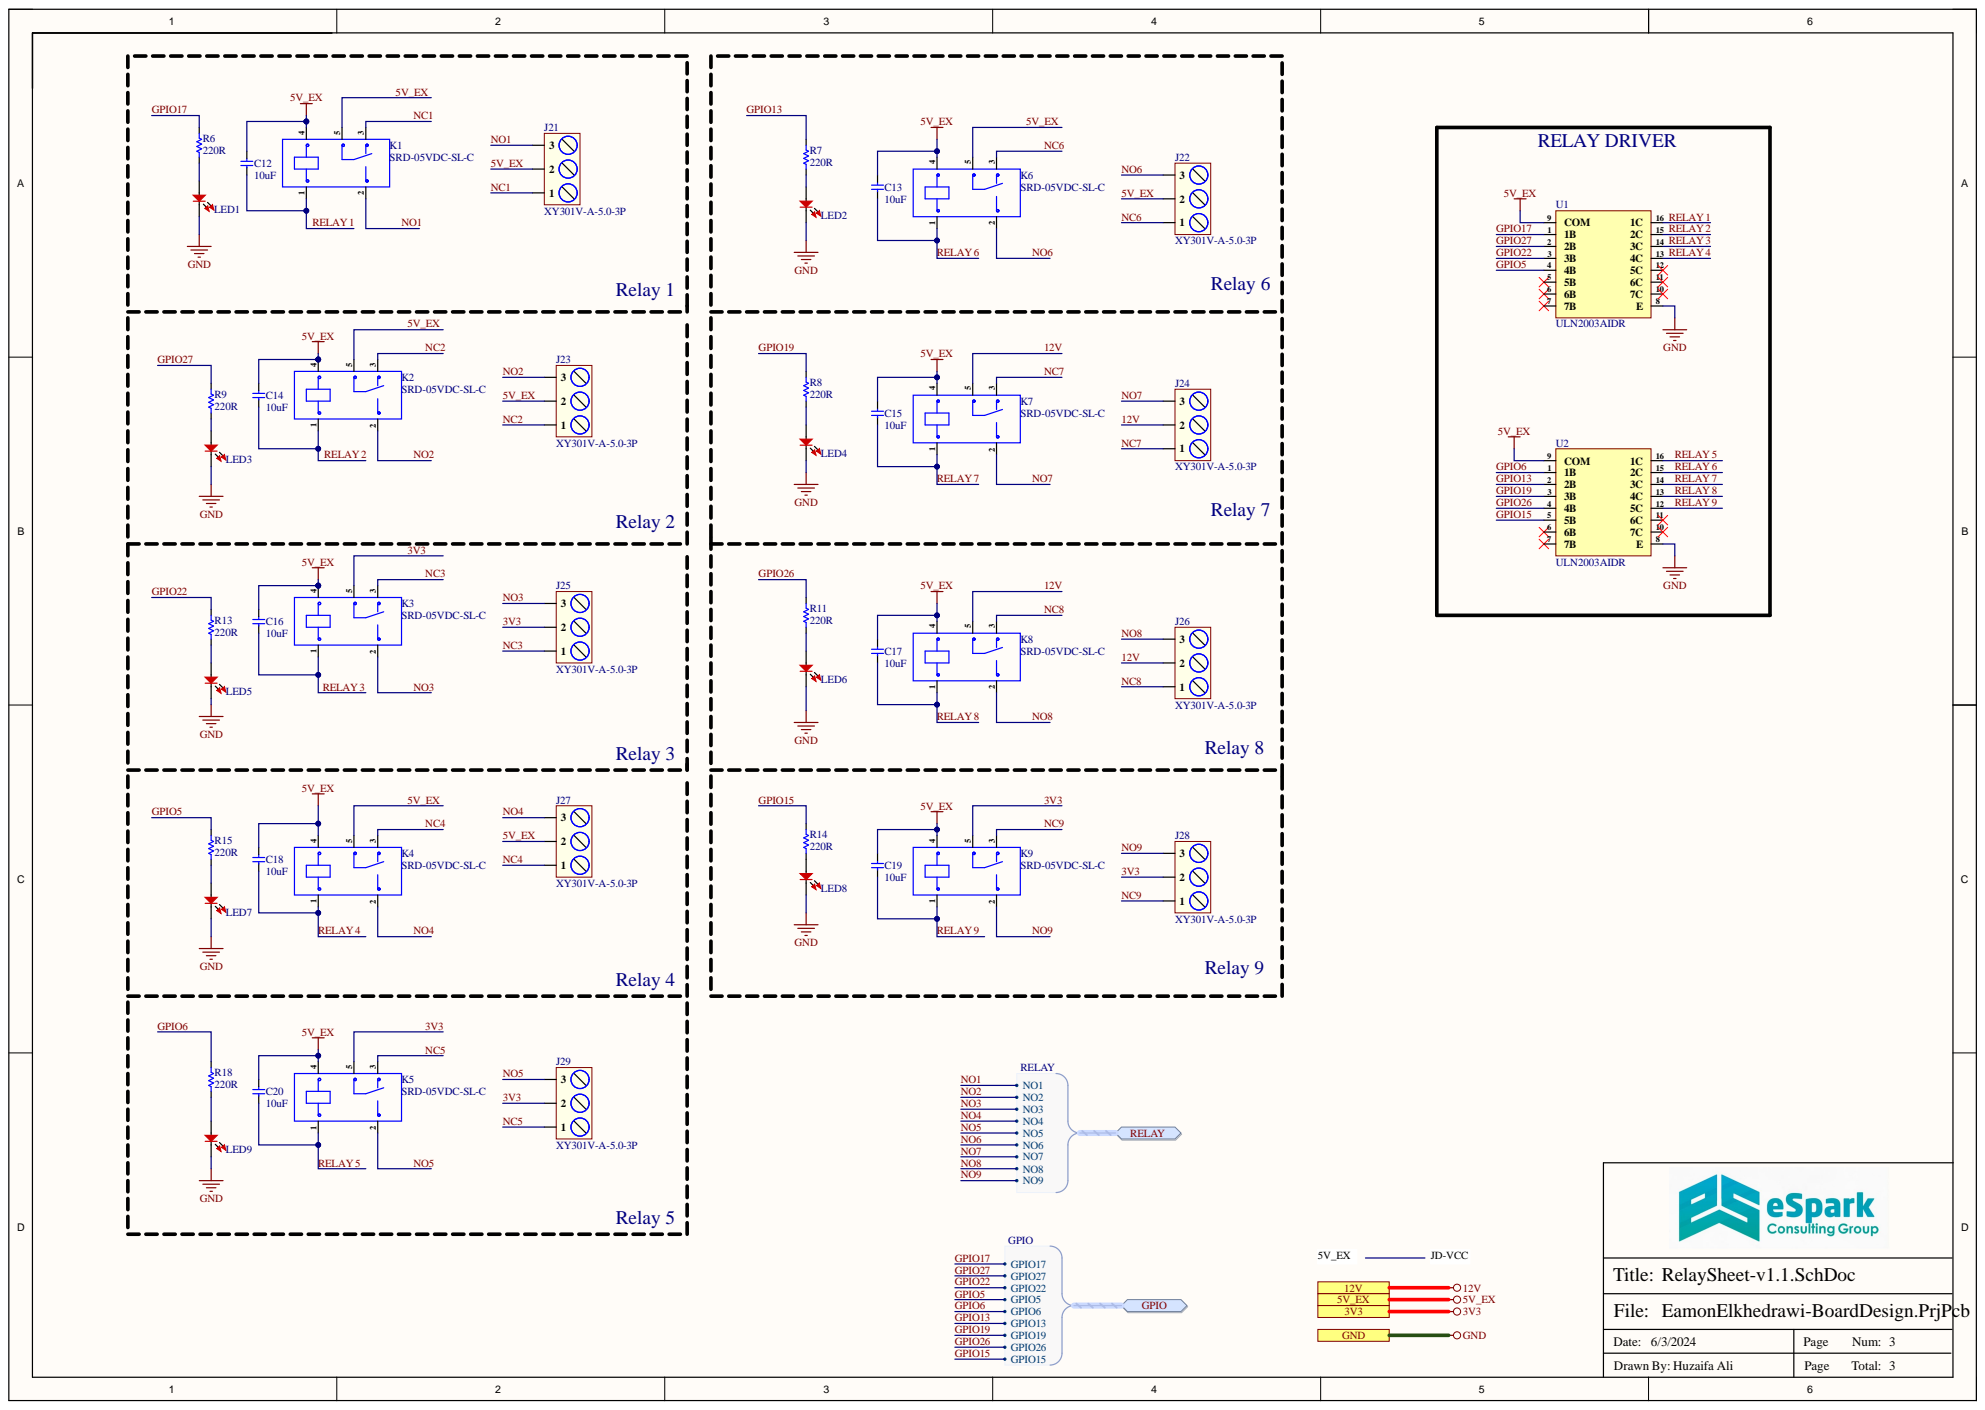
[picture p26: page 3]

Drawn By: Huzaifa Ali
