eSpark-Backup/eamonelkhedrawi-boarddesign/docs/Client-Files/Design-Files(original)/Main-PCB/Schematic_V3-Main-PCB_2024-04-14.pdf

# Relay Module WAFER⁻PH².0⁻3PWB

# Completed Modification/Changes

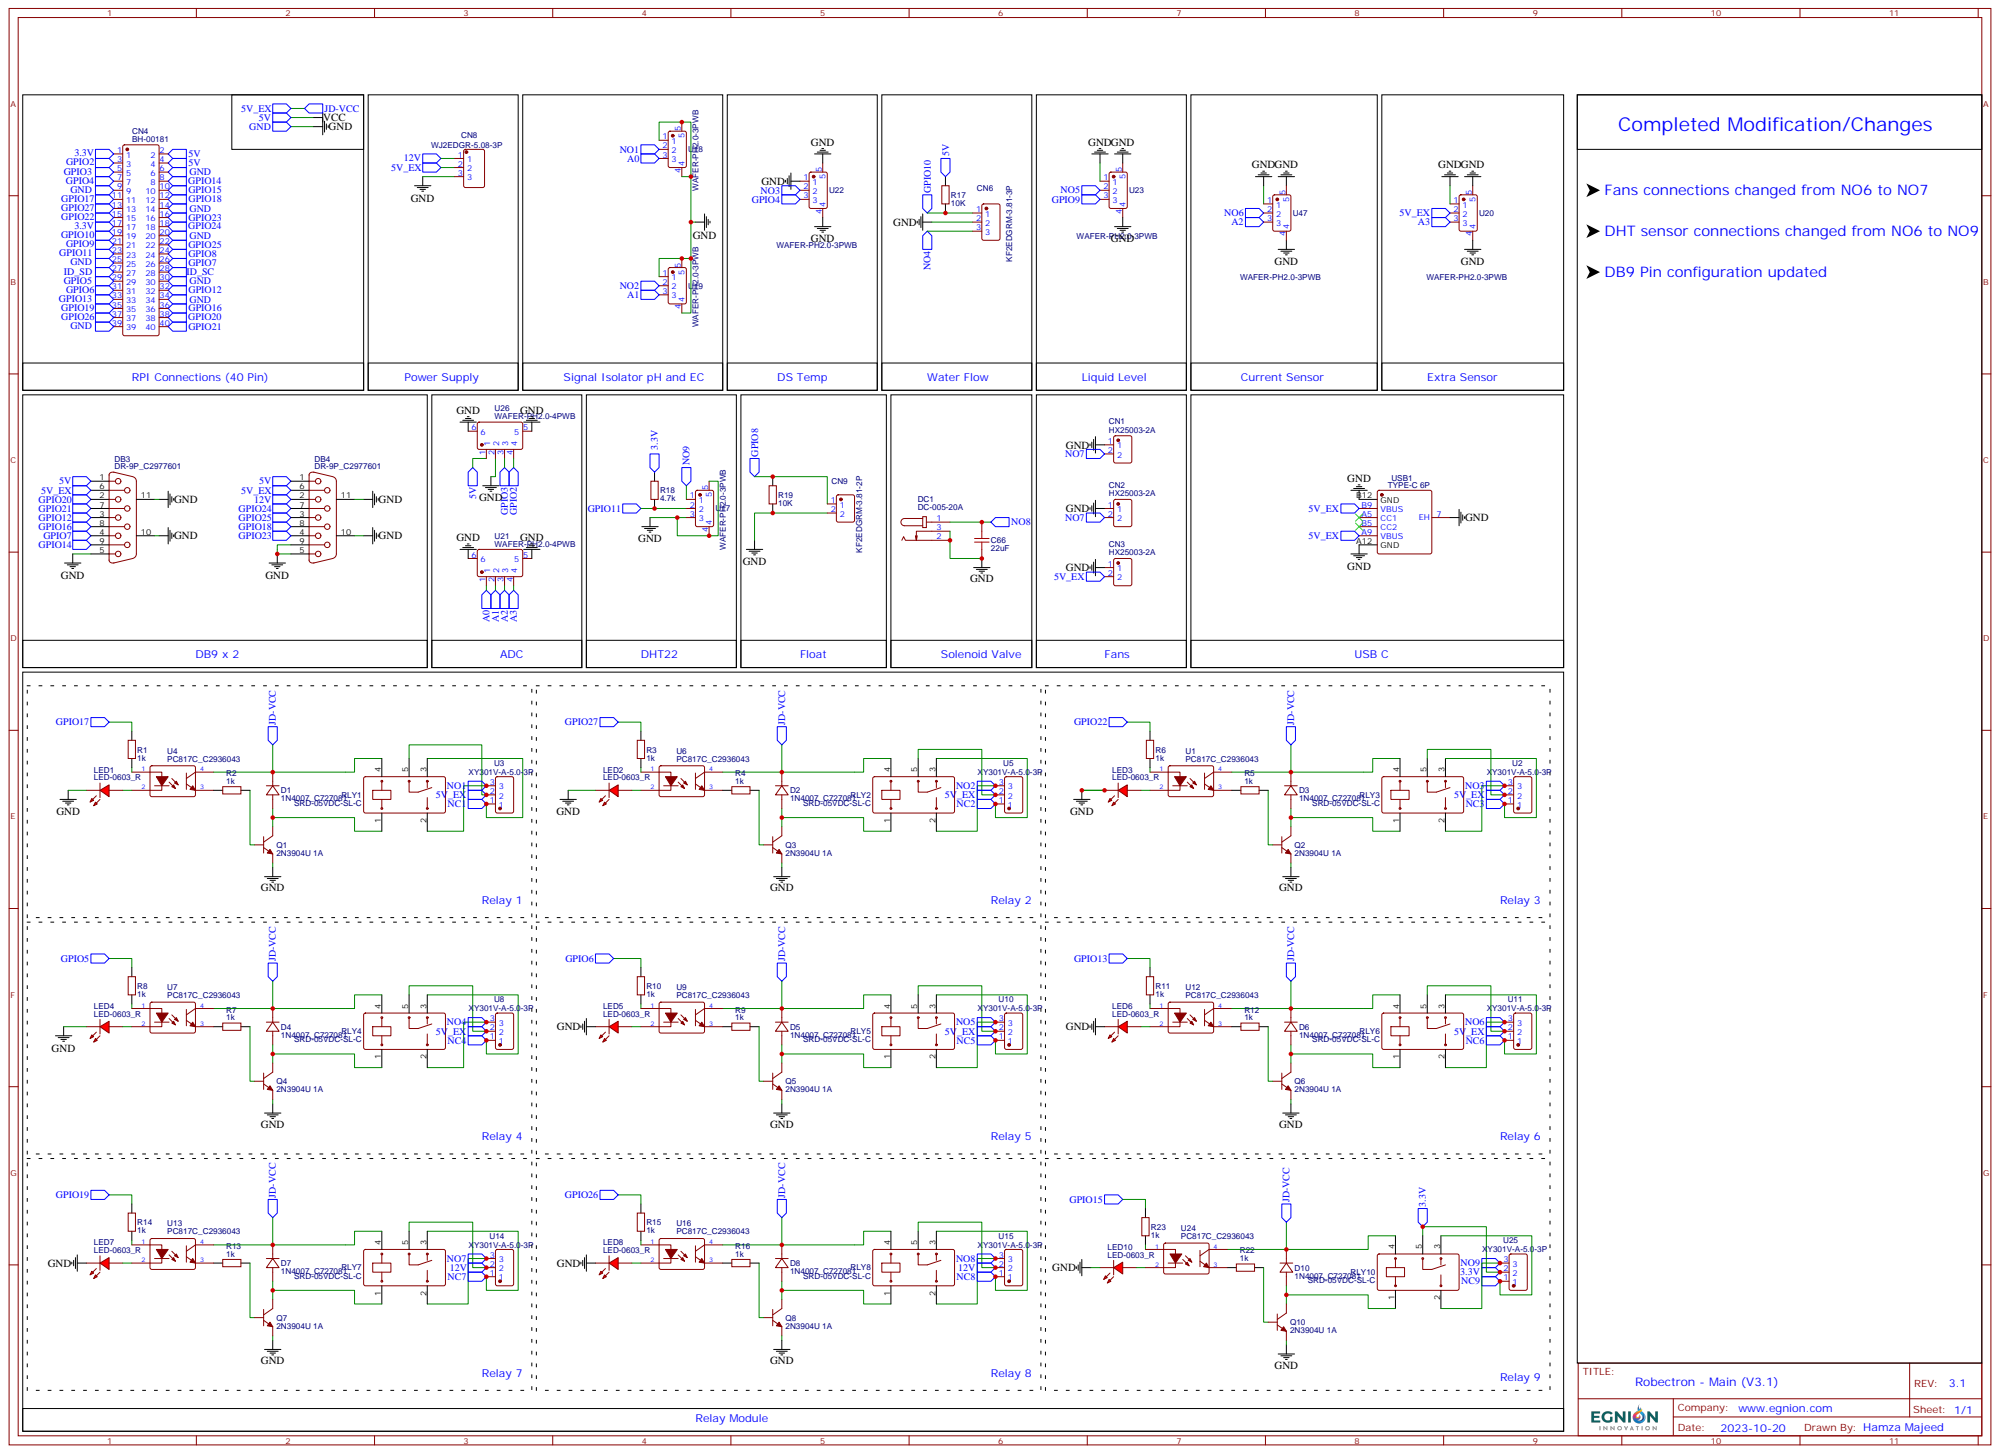
[picture p27: page 1]

Fans connections changed from NO6 to NO7

DHT sensor connections changed from NO6 to NO9

Signal Isolator pH and EC

Company: www.egnion.com

Drawn By: Hamza Majeed
