eSpark-Backup/eamonelkhedrawi-boarddesign/Design Files/Chemist-PCB/Deliverables/Schematic/Assembly Drawing.pdf

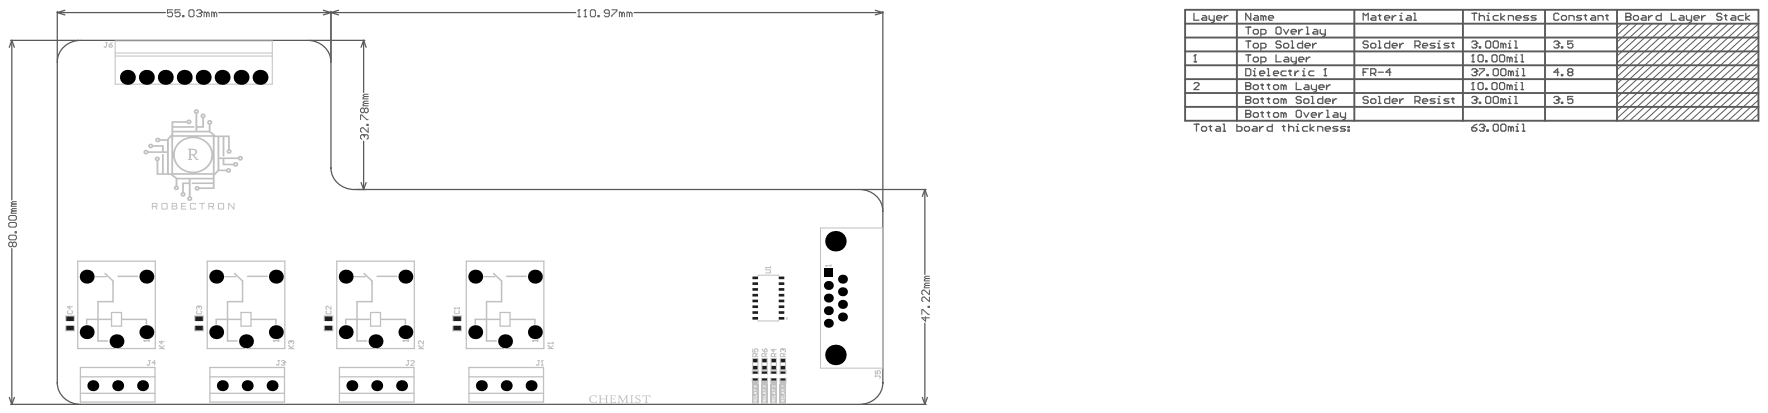
[picture p28: page 1]

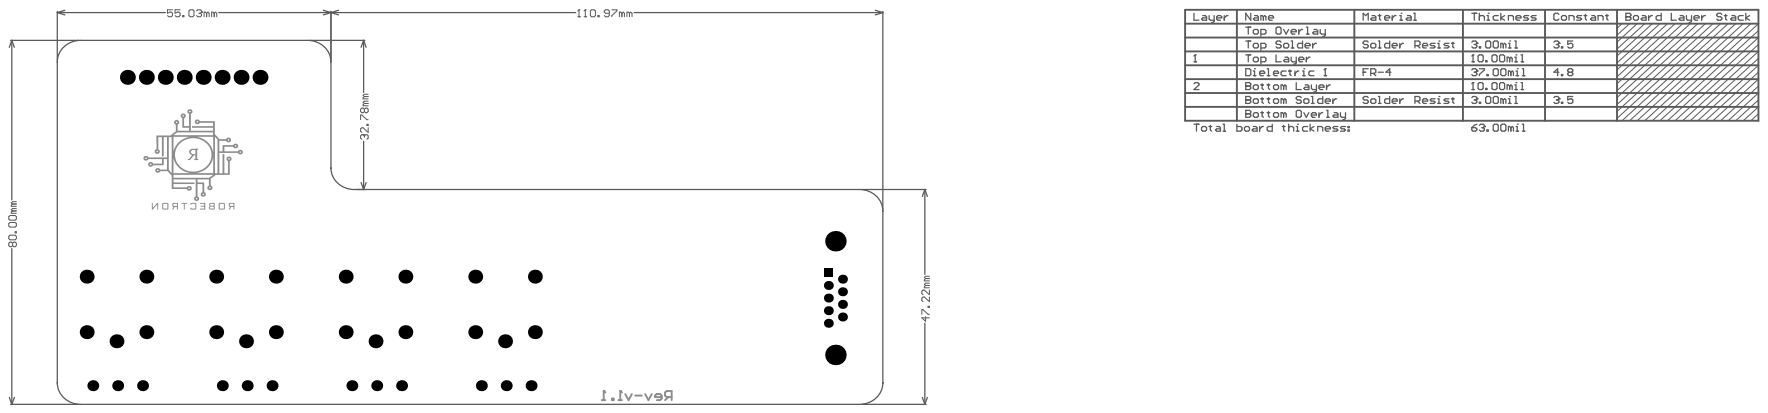
[picture p29: page 2]
