eSpark-Backup/eamonelkhedrawi-boarddesign/Design Files/Chemist-PCB/Deliverables/Schematic/Chemist-PCB.pdf

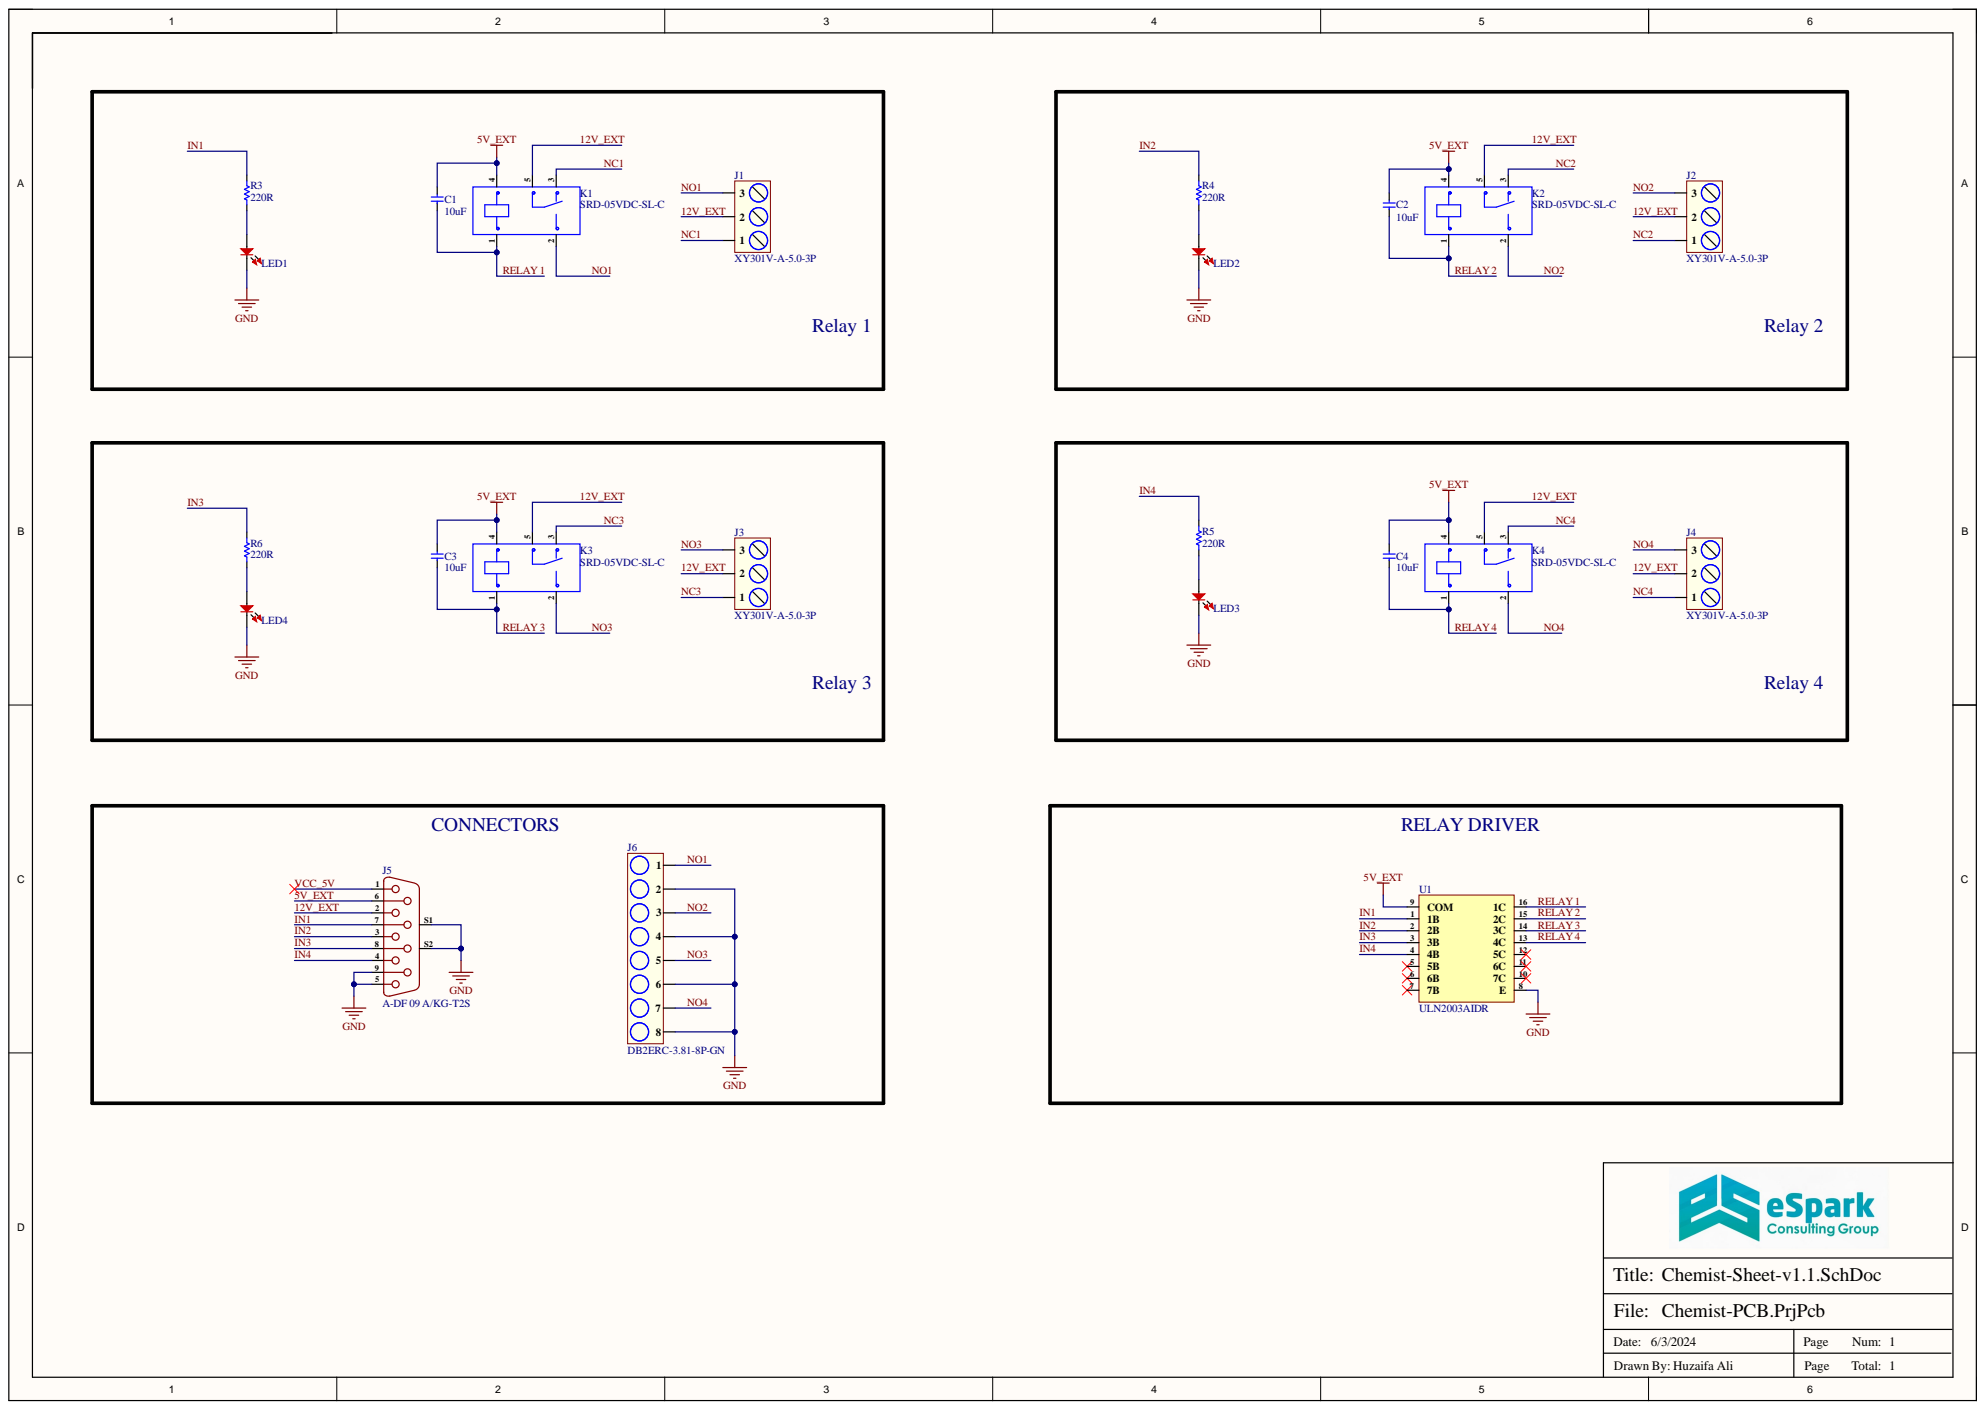
[picture p30: page 1]

Date : 6/3 /2 0 2 4 | Pag e Nu m : 11

Drawn By: Huzaifa Ali | Pag e Total :
