eSpark-Backup/eamonelkhedrawi-boarddesign/Design Files/Main-PCB/Deliverables/Schematic/Assembly Drawing.pdf

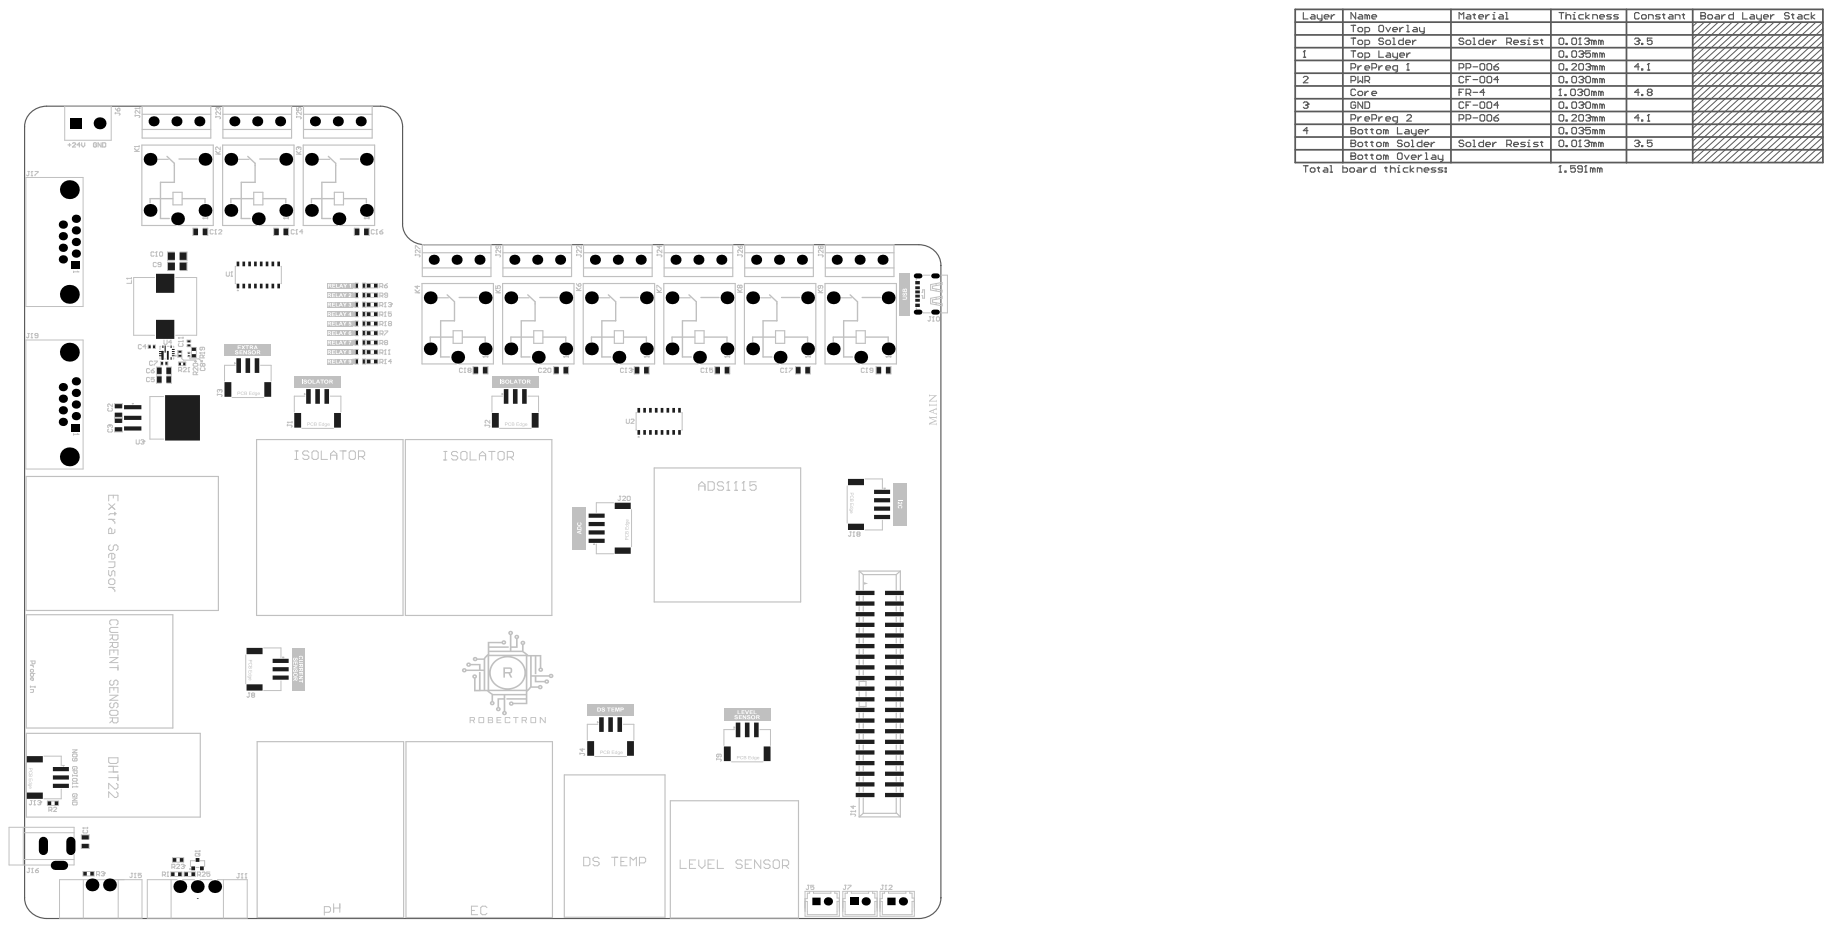
[picture p31: page 1]

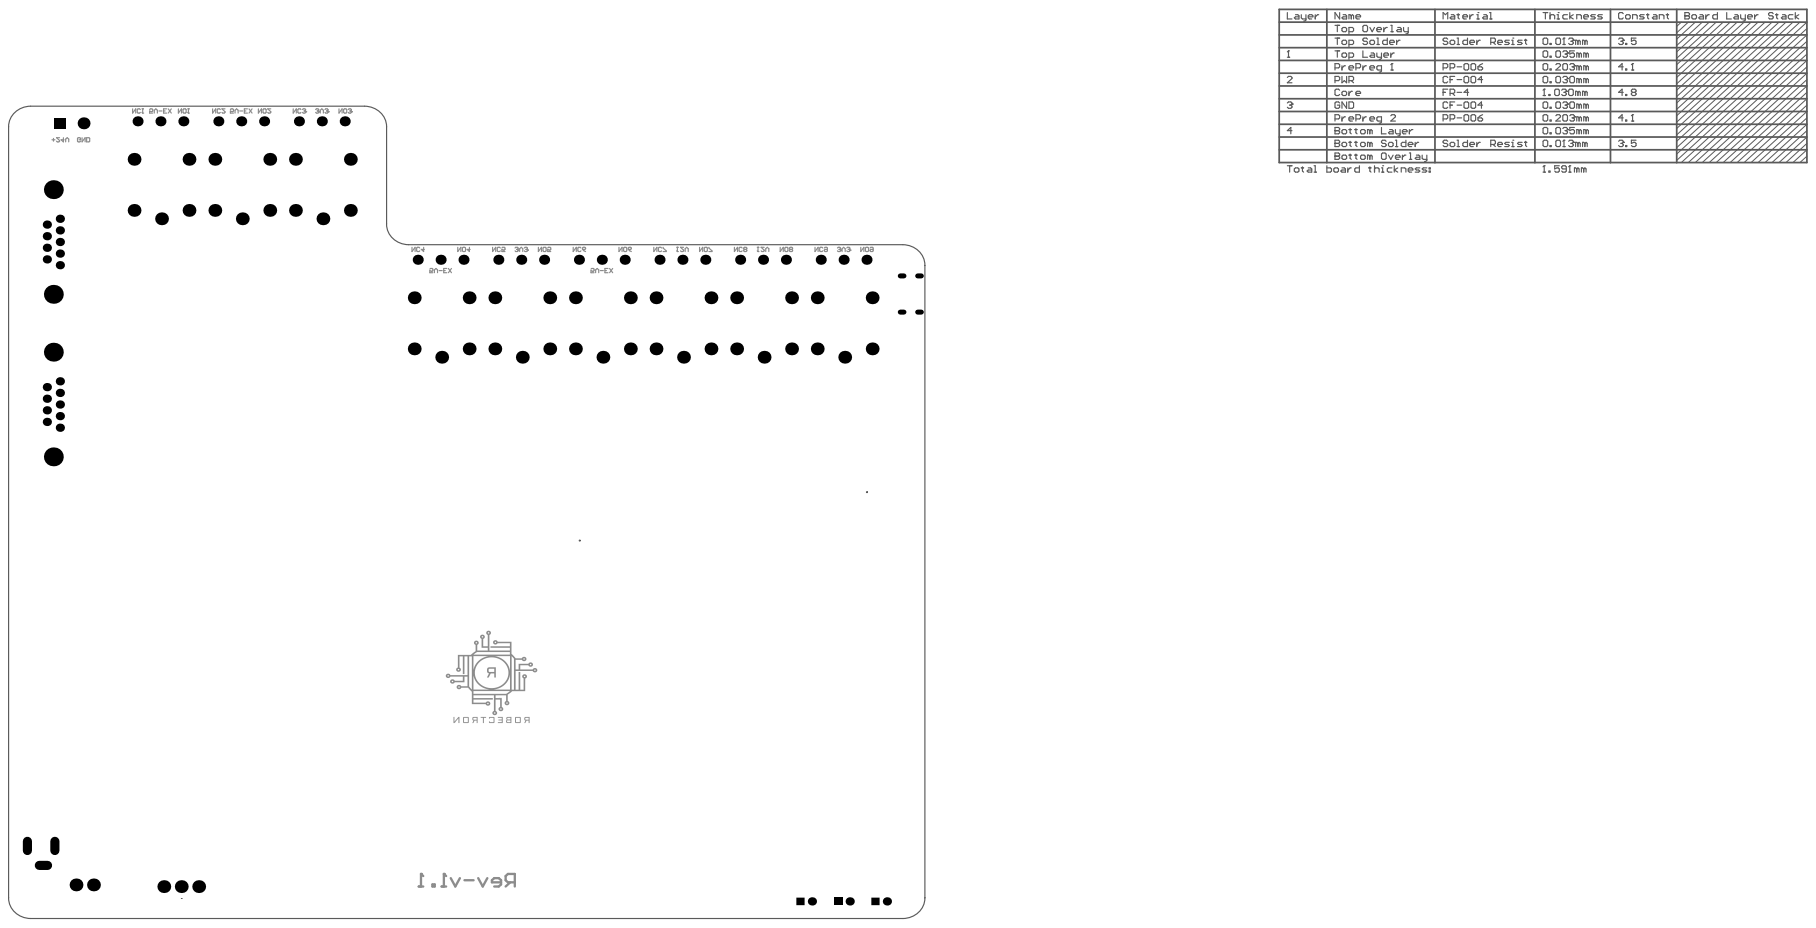
[picture p32: page 2]

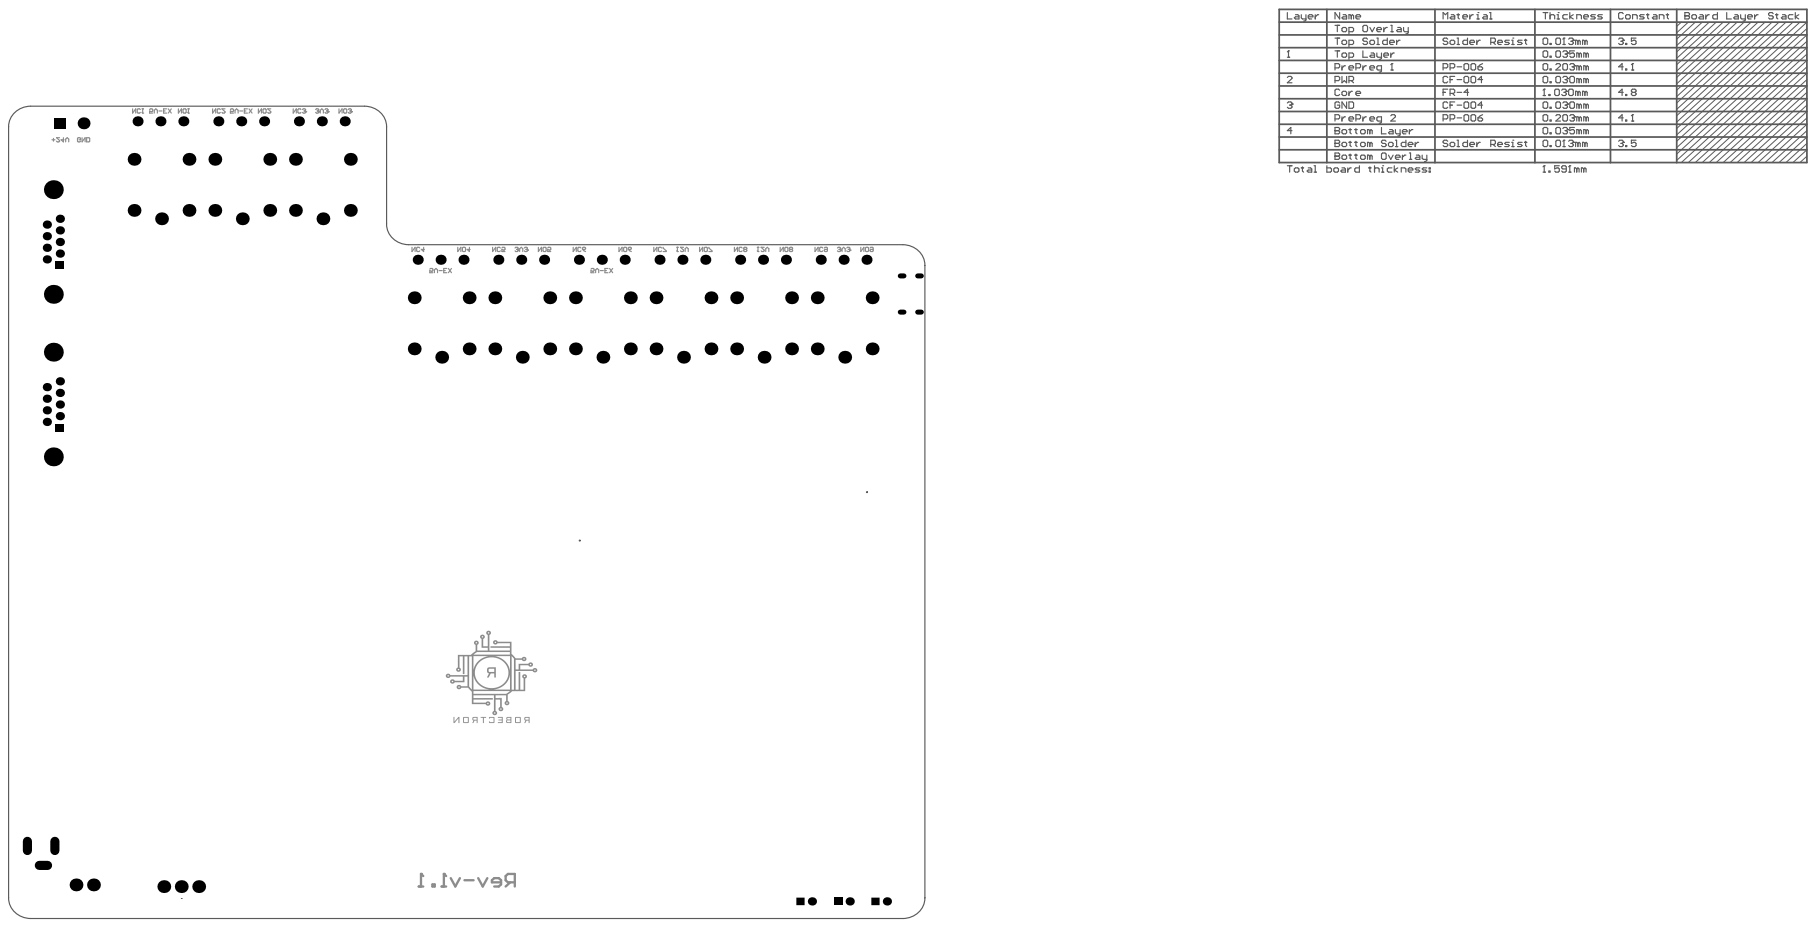
[picture p33: page 4]
