eSpark-Backup/eamonelkhedrawi-boarddesign/Design Files/Power-PCB/Deliverables/Schematic/Assembly Drawing.pdf

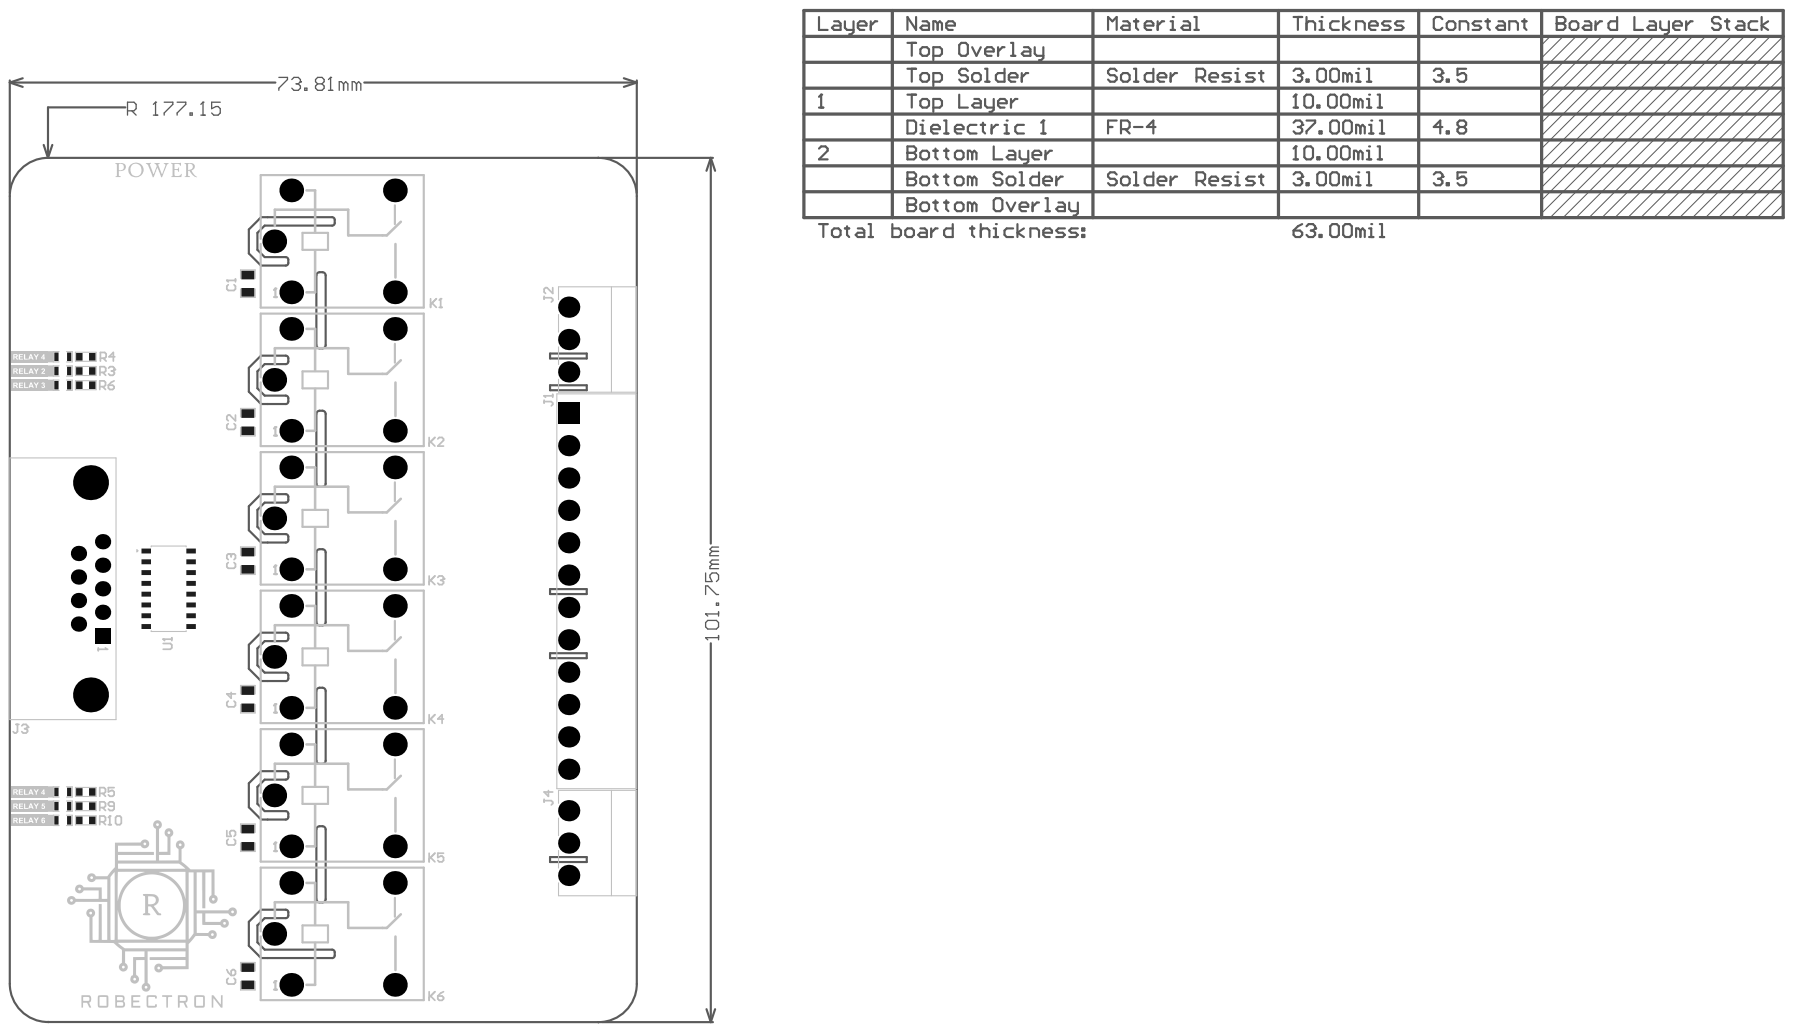
[picture p34: page 1]

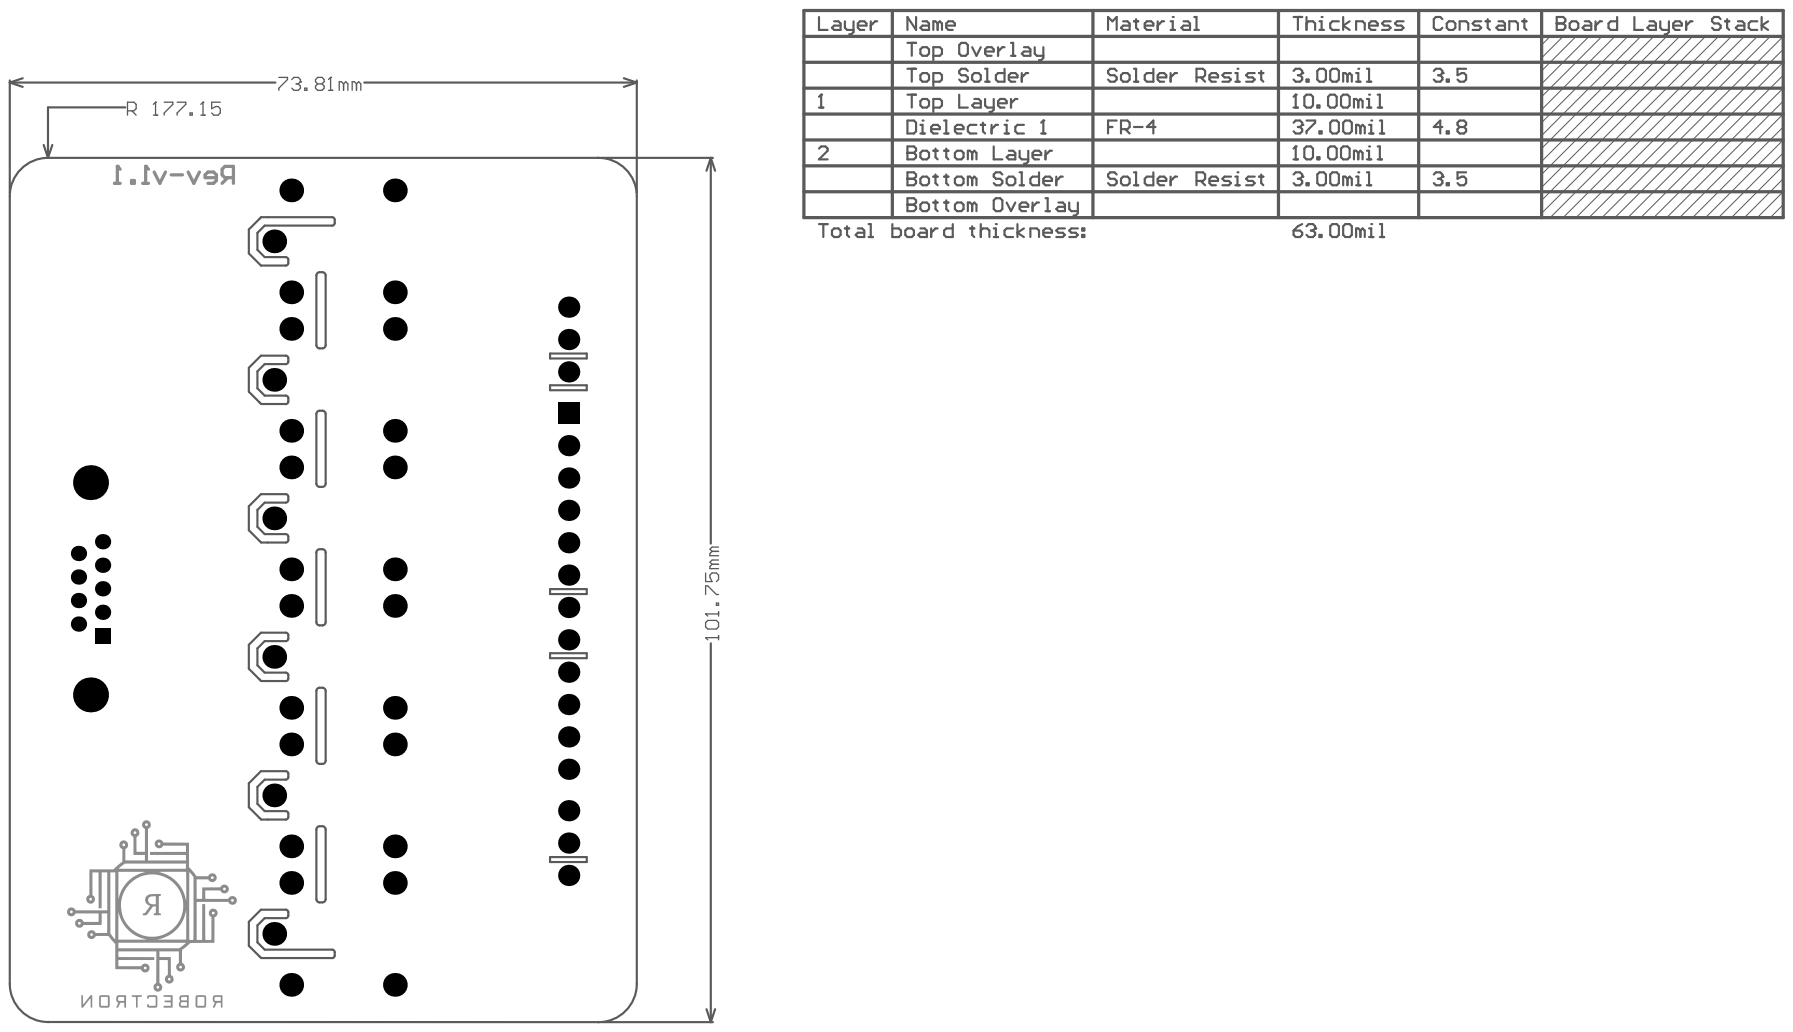
[picture p35: page 2]
