eSpark-Backup/eamonelkhedrawi-boarddesign/Design Files/Power-PCB/Deliverables/Schematic/Power-PCB.pdf

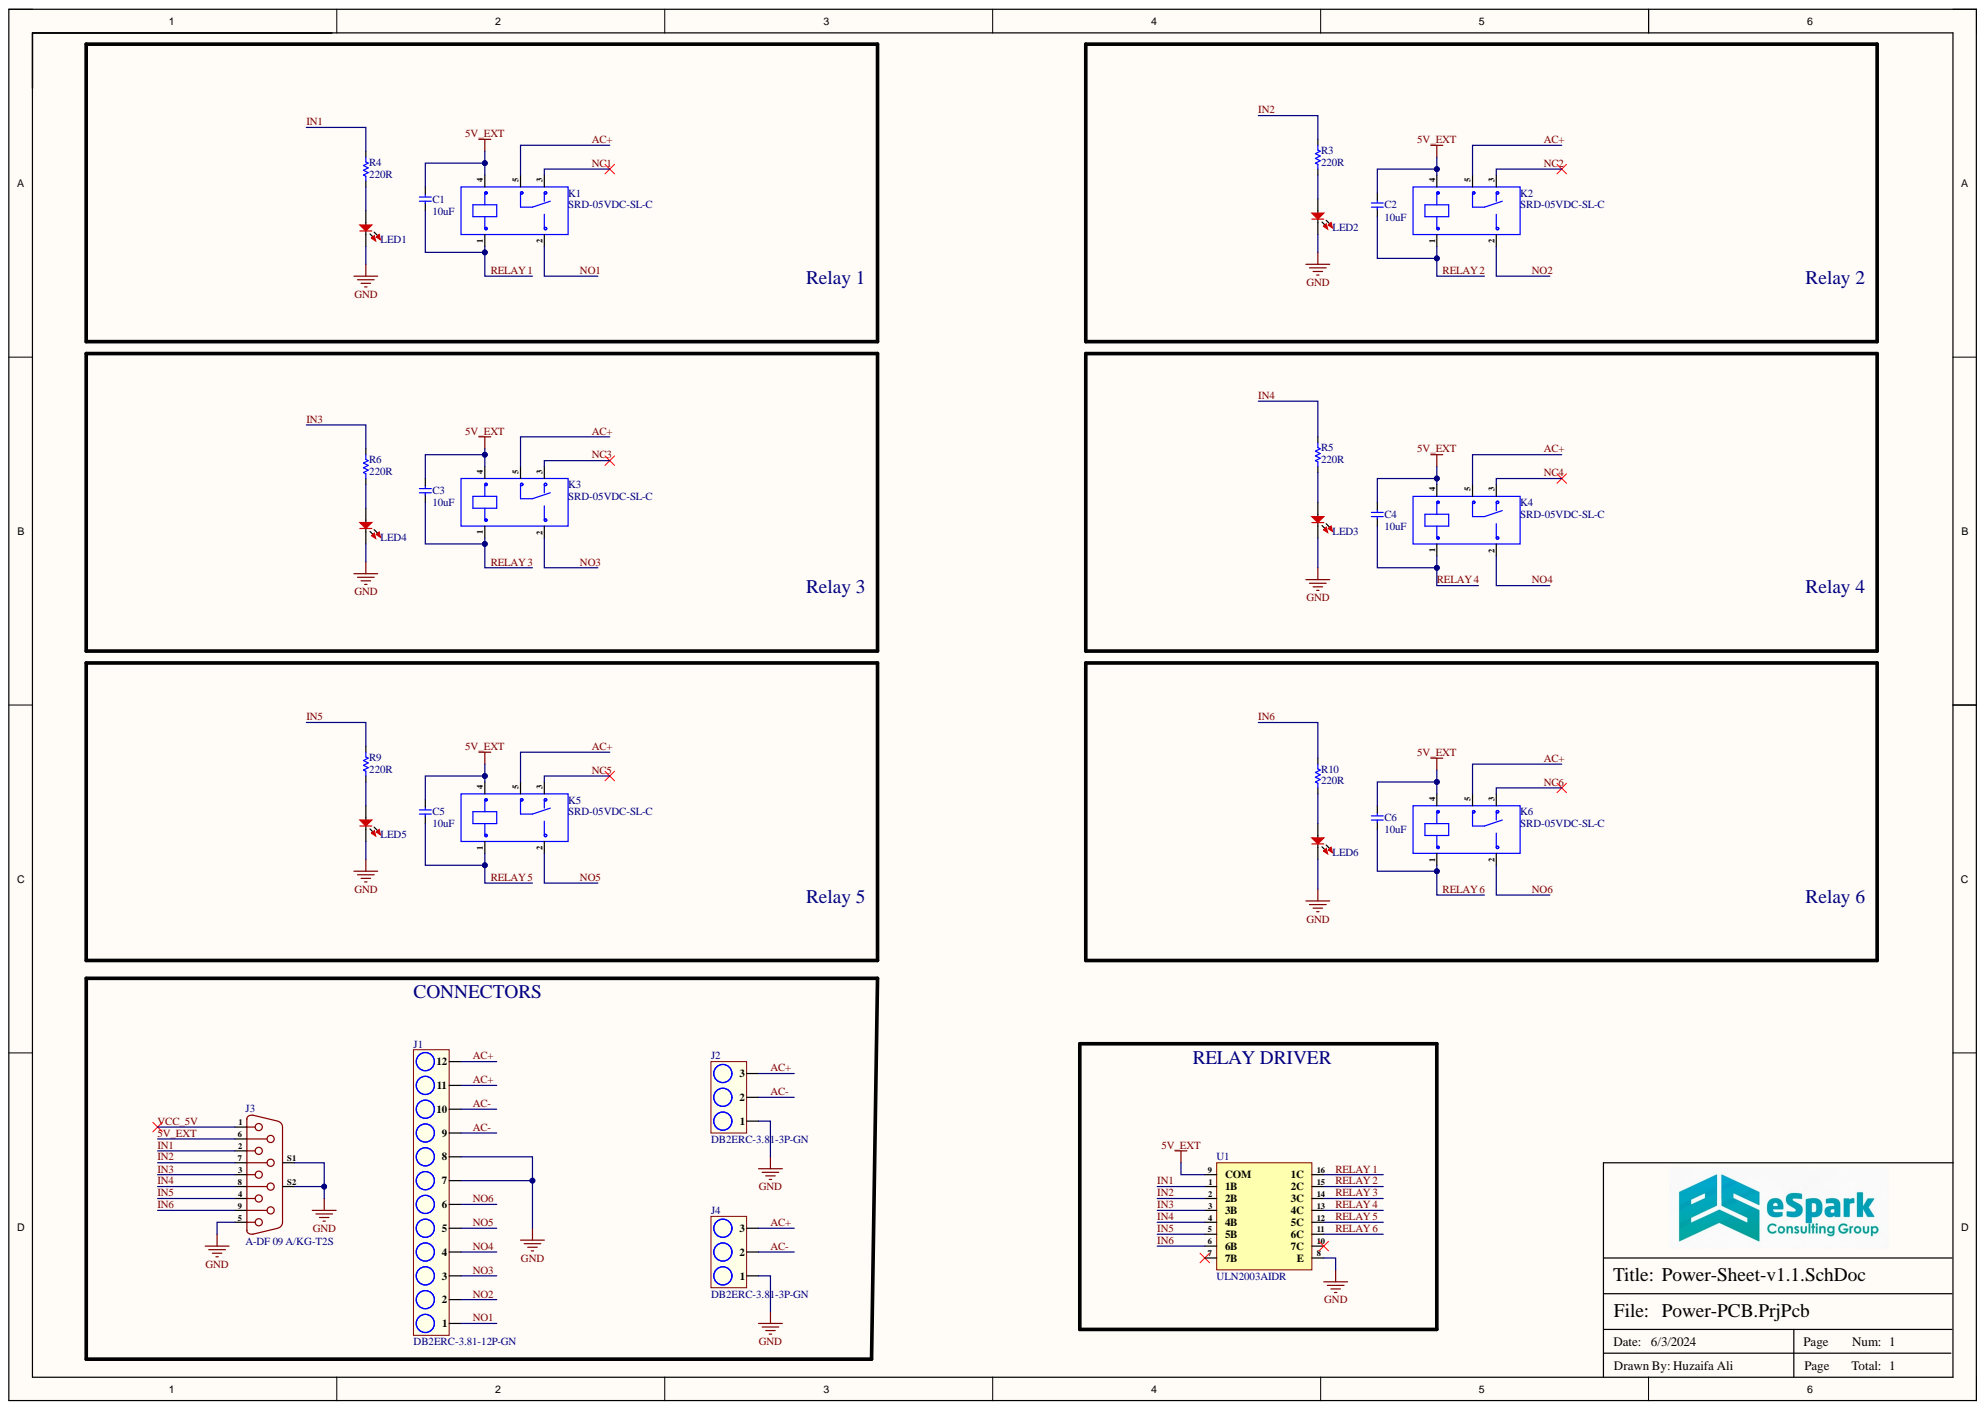
[picture p36: page 1]

Drawn By: Huzaifa Ali
