eSpark-Backup/eamonelkhedrawi-boarddesign/(list of files, drawings)

Other design files:
Design Files/Chemist-PCB/Chemist-PCB.PrjPcb
Design Files/Chemist-PCB/Chemist-Sheet-v1.1.SchDoc
Design Files/Chemist-PCB/Chemist.PcbDoc
Design Files/Main-PCB/ConnectorSheet-v1.1.SchDoc
Design Files/Main-PCB/EamonElkhedrawi-BoardDesign.PrjPcb
Design Files/Main-PCB/MainPCB.PcbDoc
Design Files/Main-PCB/RelaySheet-v1.1.SchDoc
Design Files/Main-PCB/Top-Sheet.SchDoc
Design Files/Power-PCB/Power-PCB.PrjPcb
Design Files/Power-PCB/Power-Sheet-v1.1.SchDoc
Design Files/Power-PCB/Power.PcbDoc
docs/Client-Files/Design-Files(original)/Chemist-PCB/PCB_PCB_Robectron-Chemist_2023-11-16.json
docs/Client-Files/Design-Files(original)/Chemist-PCB/SCH_Robectron-Chemist_2023-11-16.json
docs/Client-Files/Design-Files(original)/Main-PCB/PCB_PCB_Eamon Elkhedrawi_2023-11-23.json
docs/Client-Files/Design-Files(original)/Main-PCB/SCH_Eamon Elkhedrawi_2023-11-23.json
docs/Client-Files/Design-Files(original)/Power-PCB/PCB_PCB_Robectron-Power_2023-11-16.json
docs/Client-Files/Design-Files(original)/Power-PCB/SCH_Robectron-Power_2023-11-16.json
