eSpark-Backup/eamonelkhedrawi-boarddesign/(commit log)

2024-04-17 Client Files pushed (gitignore added)
    [PCB_PCB_Eamon Elkhedrawi_2023-11-23.json, SCH_Eamon Elkhedrawi_2023-11-23.json]
2024-04-17 #1 In progress
    [BoardDesign-v1.0.SchDoc, EamonElkhedrawi-BoardDesign.PrjPcb]
2024-04-18 #1 In progress. Relay section remaining
    [BoardDesign-v1.0.SchDoc, ConnectorSheet-v1.0.SchDoc, EamonElkhedrawi-BoardDesign.PrjPcb, RelaySheet-v1.0.SchDoc]
2024-04-19 #1 Schematic Complete
    [ConnectorSheet-v1.0.SchDoc, EamonElkhedrawi-BoardDesign.PrjPcb, RelaySheet-v1.0.SchDoc, Top-Sheet.SchDoc]
2024-04-24 PowerPCB and ChemistPCB client files pushed
    [PCB_PCB_Eamon Elkhedrawi_2023-11-23.json, PCB_PCB_Robectron-Chemist_2023-11-16.json, PCB_PCB_Robectron-Power_2023-11-16.json, SCH_Eamon Elkhedrawi_2023-11-23.json, SCH_Robectron-Chemist_2023-11-16.json, SCH_Robectron-Power_2023-11-16.json]
2024-04-25 #1 Project Folders Created
    [Chemist-PCB.PrjPcb, ConnectorSheet-v1.0.SchDoc, EamonElkhedrawi-BoardDesign.PrjPcb, Power-PCB.PrjPcb, RelaySheet-v1.0.SchDoc, Sheet1.SchDoc, Top-Sheet.SchDoc]
2024-04-26 #1 Schematic Moved to Altium
    [Chemist-PCB.PrjPcb, Chemist-Sheet.SchDoc, Power-PCB.PrjPcb, Power-Sheet.SchDoc, RelaySheet-v1.0.SchDoc, Sheet1.SchDoc]
2024-04-29 #1 Relay Driver ULN2003 Chip Added to All 3 Schematics
    [Chemist-Sheet.SchDoc, Power-Sheet.SchDoc, RelaySheet-v1.0.SchDoc]
2024-04-30 #1 ULN2003AIDR Part Updated
    [Chemist-Sheet.SchDoc, Power-Sheet.SchDoc, RelaySheet-v1.0.SchDoc]
2024-05-08 #4 In Progress
    [ConnectorSheet-v1.0.SchDoc, ConnectorSheet-v1.1.SchDoc, EamonElkhedrawi-BoardDesign.PrjPcb, RelaySheet-v1.0.SchDoc, RelaySheet-v1.1.SchDoc]
2024-05-08 #4 Complete.
    [Chemist-PCB.PrjPcb, Chemist-Sheet-v1.1.SchDoc, Chemist-Sheet.SchDoc, ConnectorSheet-v1.1.SchDoc, Power-PCB.PrjPcb, Power-Sheet-v1.1.SchDoc, Power-Sheet.SchDoc, RelaySheet-v1.1.SchDoc]
2024-05-21 #4 Design Changes on 21/05/24
    1. hange voltage for the data wire of the waterflow 5V sensor to 3.3v as the raspberry pi cant handle more than 5v input (either use resistors or logic level converter)
    2. Change the input of the temperature ds1820b from 5V to 3.3V. Do verify the range first
    3. Change the float switch voltage to 3.3V
    4. Change voltage for liquid level sensor to 3.3V
    5. Ensure enough voltage and current of at least 5A can reach the raspberry pi
    [ConnectorSheet-v1.1.SchDoc, RelaySheet-v1.1.SchDoc]
2024-05-21 #4 Water Flow Sensor Changes. 3.3V LOGIC translator added.
    [ConnectorSheet-v1.1.SchDoc]
2024-05-22 #5 Chemist and Power Board Placement completed.
    [Chemist-PCB.PrjPcb, Chemist.PcbDoc, Power-PCB.PrjPcb, Power.PcbDoc]
2024-05-23 #5 Main Board Placement completed. Client's approval remaining
    [EamonElkhedrawi-BoardDesign.PrjPcb, MainPCB.PcbDoc, Power.PcbDoc]
2024-05-24 #5 Power board design routing complete. Finishing remaining
    [MainPCB.PcbDoc, Power-PCB.PrjPcb, Power.PcbDoc]
2024-05-29 #5 Chemist and Power PCB Design completed. Main PCB is in progress
    [Chemist-PCB.PrjPcb, Chemist.PcbDoc, MainPCB.PcbDoc, Power.PcbDoc]
2024-05-30 #5 Main PCB's power routing and finishing remaining.
    [MainPCB.PcbDoc]
2024-05-31 #4 GND connection added to Connector J3
    [ConnectorSheet-v1.1.SchDoc]
2024-05-31 #5 Design completed
    [EamonElkhedrawi-BoardDesign.PrjPcb, MainPCB.PcbDoc]
2024-06-03 #4 Relay designators changed from R to K
    [Chemist-Sheet-v1.1.SchDoc, Power-Sheet-v1.1.SchDoc, RelaySheet-v1.1.SchDoc]
2024-06-03 #5 All 3 of the Designs (Main, PWR and Chemist) are completed. Deliverables generated
    [Centroid File.csv, Chemist-PCB.PrjPcb, Chemist.DWG, Chemist.DXF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]
2024-06-10 #5 Altium BOM generated
    [Chemist-PCB.xlsx, EamonElkhedrawi-BoardDesign.xlsx, Power-PCB.xlsx]
2024-06-11 #6 C8 and L1 Change in PCB and Fresh Deliverables Generated.
    [Centroid File.csv, Centroid.csv, ConnectorSheet-v1.1.SchDoc, EamonElkhedrawi-BoardDesign.PrjPcb, EamonElkhedrawi-BoardDesign.xlsx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]
2024-06-11 #6 J5 Part update in Chemist PCB BOM.
    [Chemist-PCB.xlsx]
2024-06-11 #6 DB-9 Connector part no Update in Power PCB
    [Power-PCB.xlsx]
